lukeweston/SSRPGenericTelemetryModule/FGPMMOPA6x.png

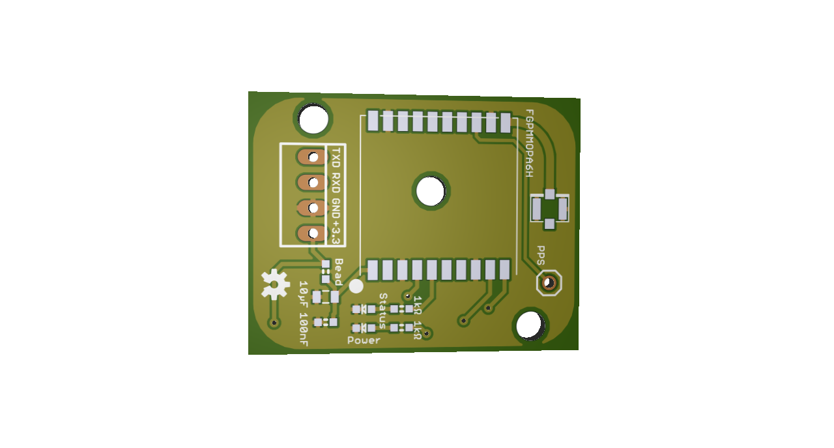
FGPMMOPA6x.png
