lukeweston/SSRPGenericTelemetryModule/HighRangeAccelerometer.png

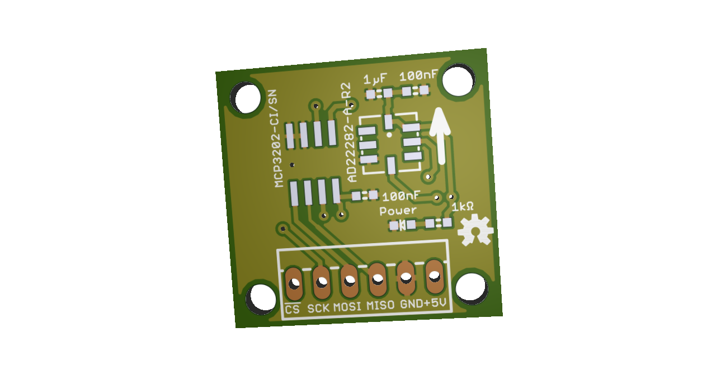
HighRangeAccelerometer.png
