lukeweston/SSRPGenericTelemetryModule/OEMV1_GPS_Interface.png

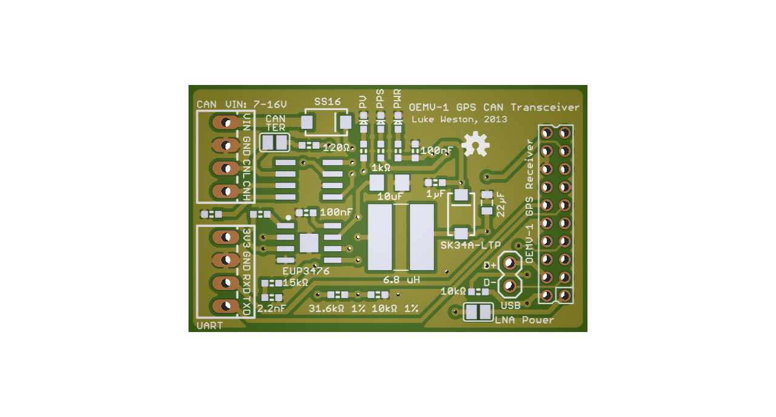
OEMV1_GPS_Interface.png
