lukeweston/SSRPGenericTelemetryModule/Venus638FLPX-L.png

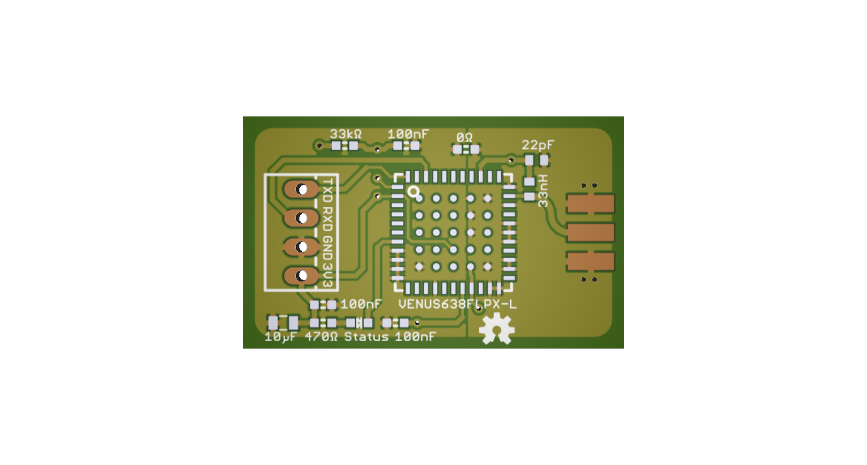
Venus638FLPX-L.png
