lukeweston/SSRPGenericTelemetryModule/FGPMMOPA6x-schematic.pdf

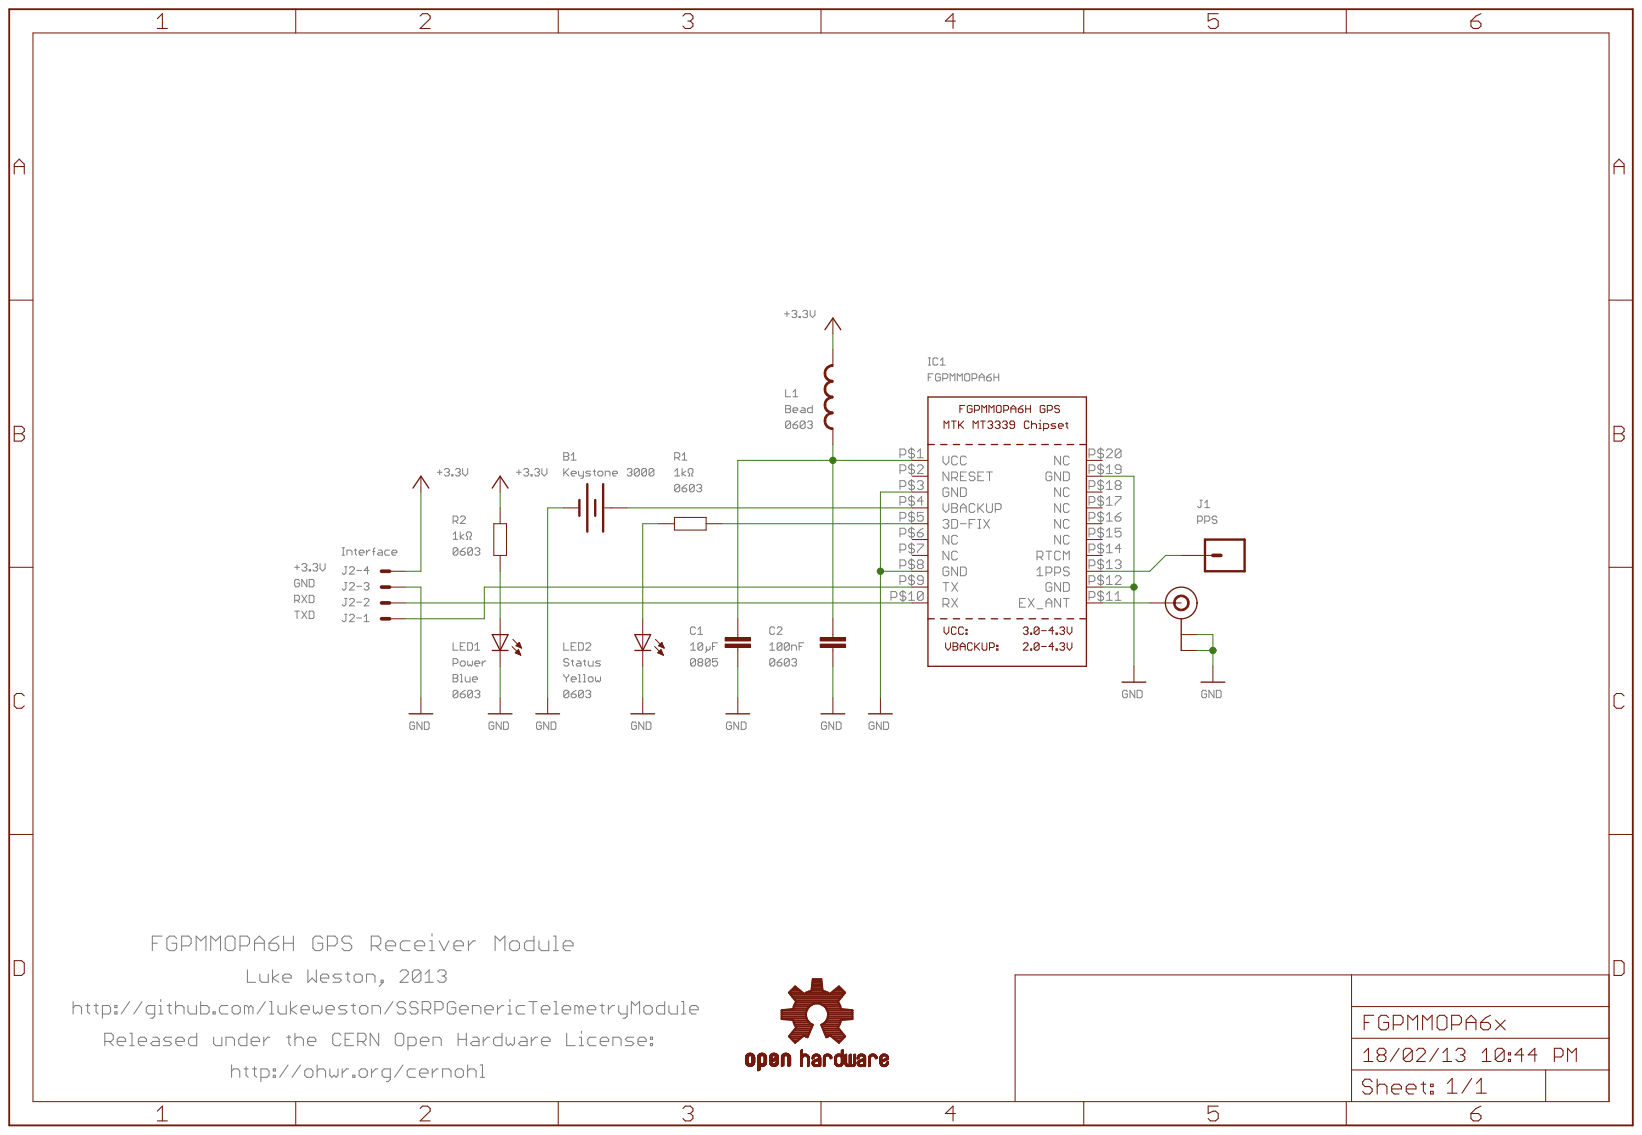
[picture p5: page 1]
