lukeweston/SSRPGenericTelemetryModule/Venus638FLPX-L-schematic.pdf

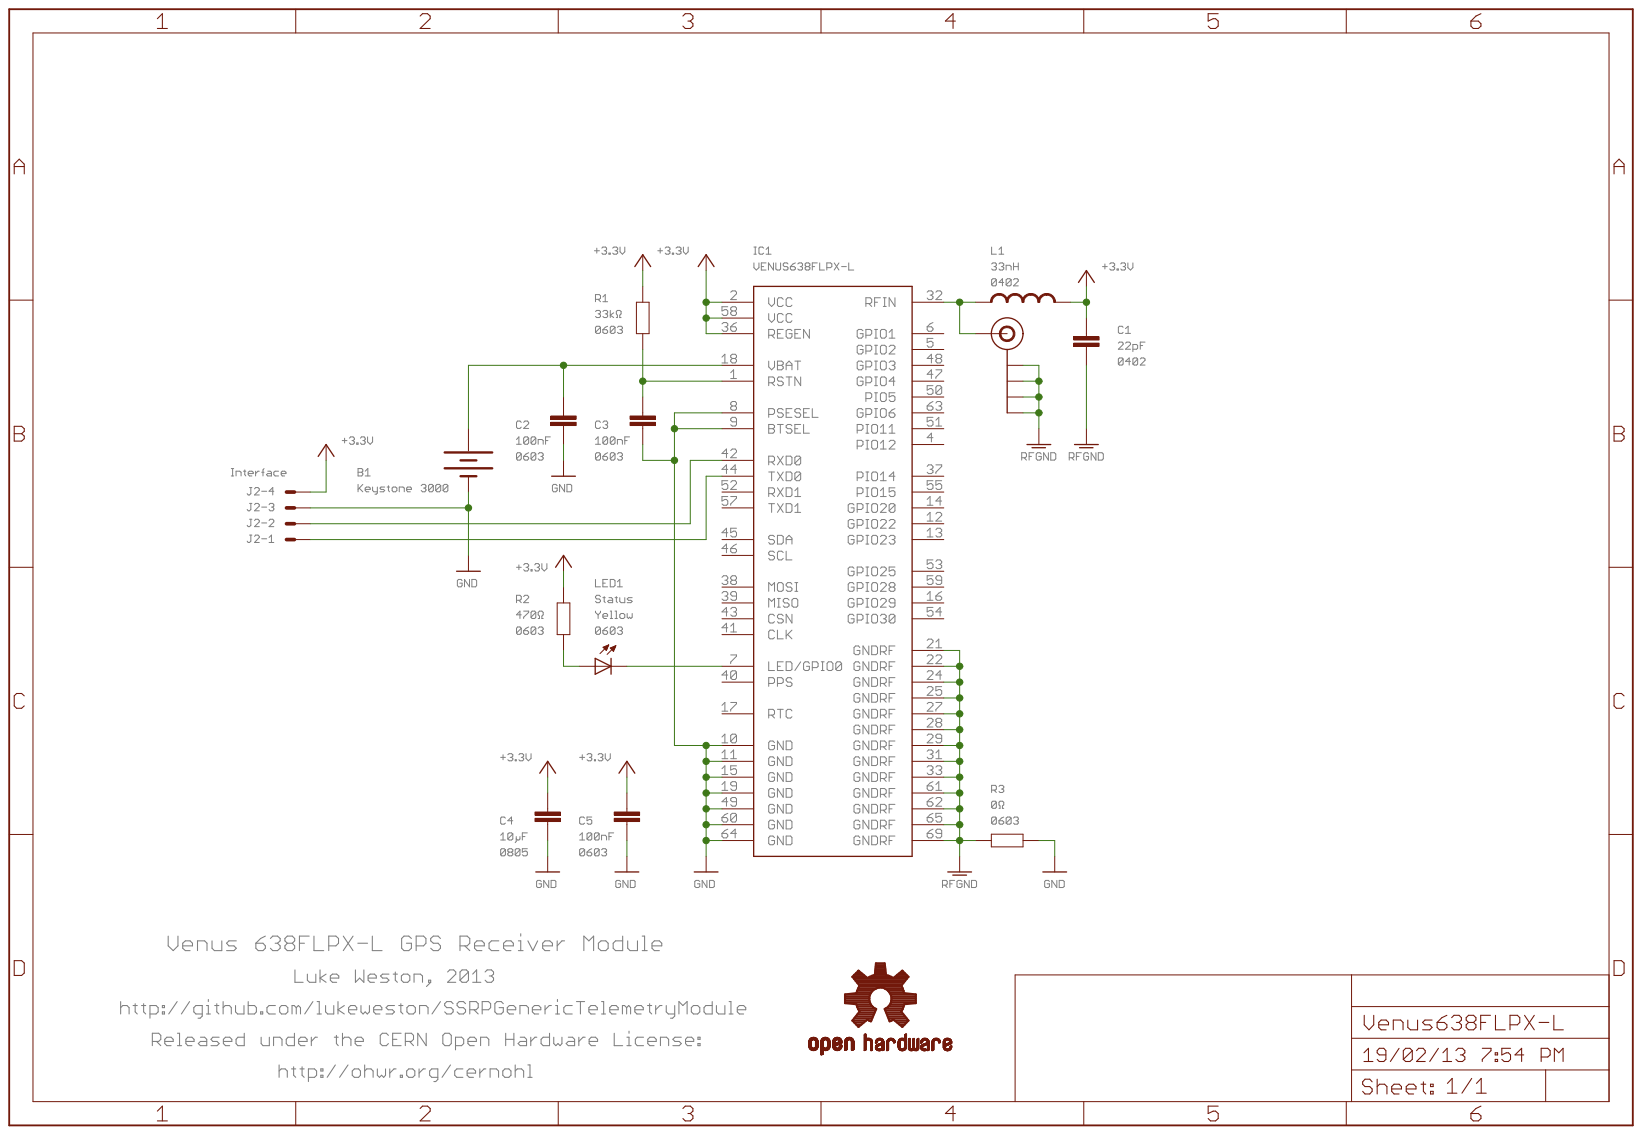
[picture p6: page 1]
