lukeweston/SSRPGenericTelemetryModule/OEMV1_GPS_Interface-schematic.pdf

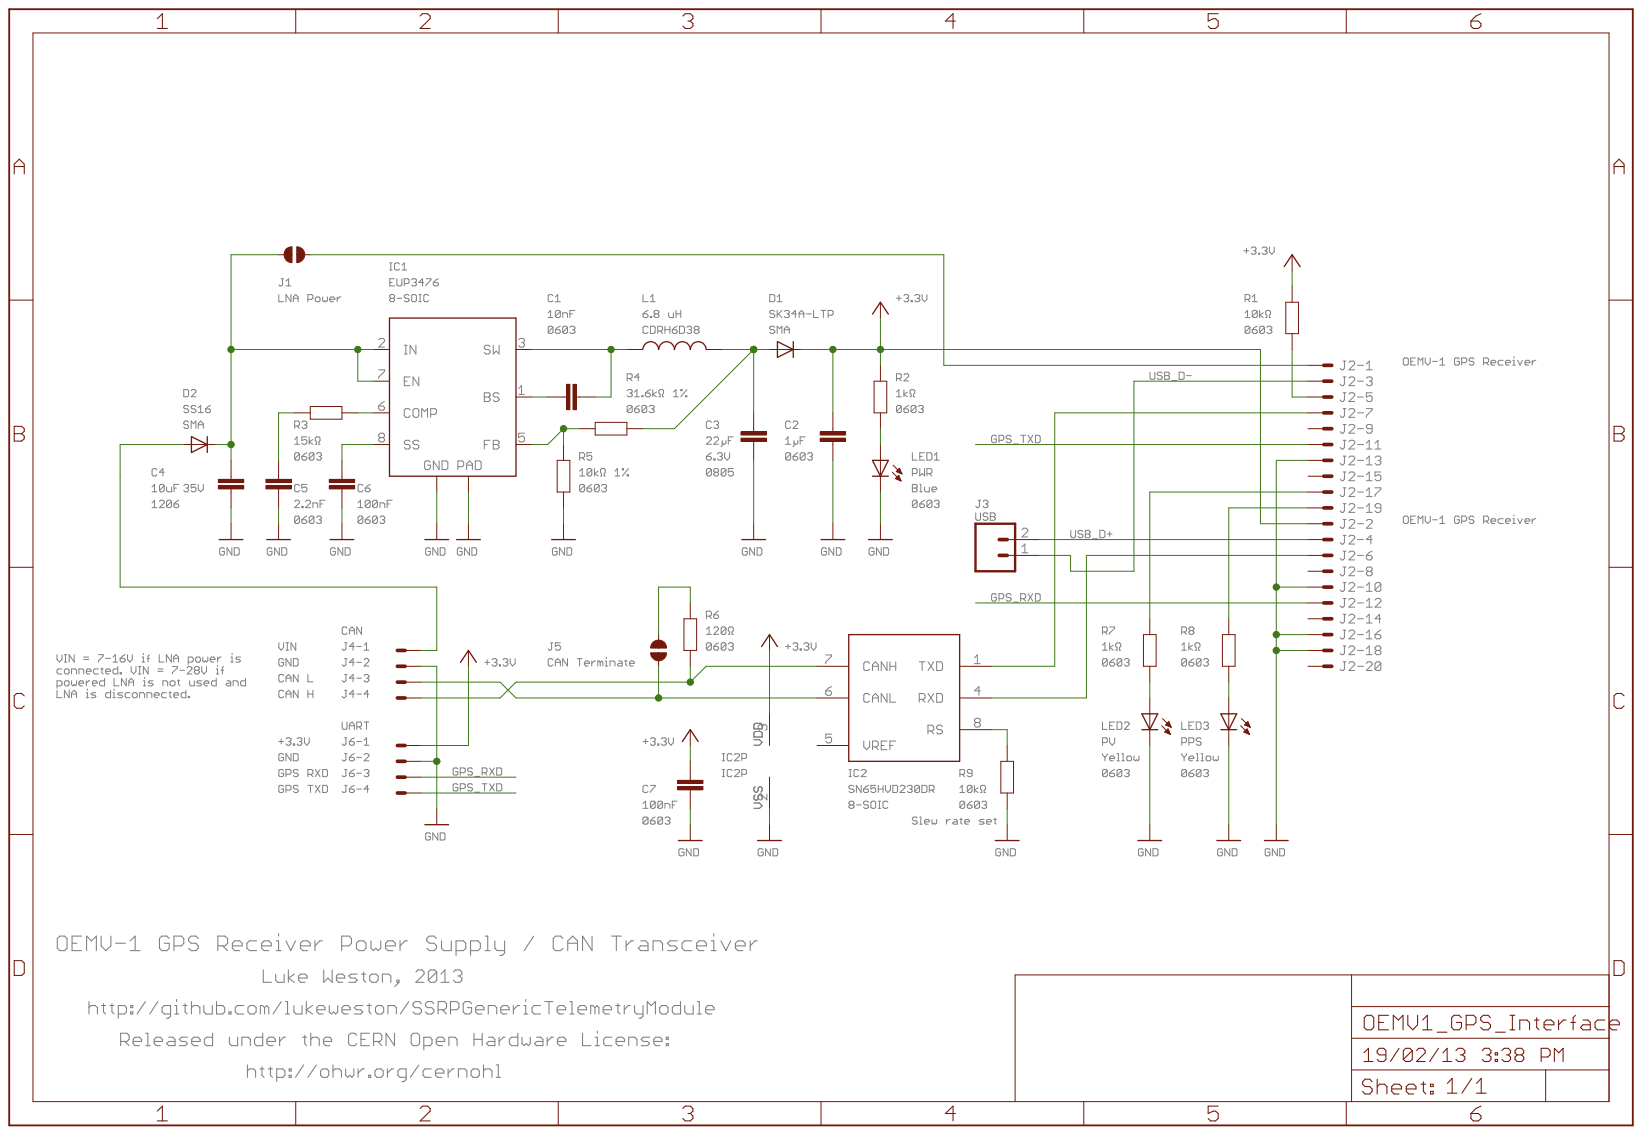
[picture p7: page 1]
