lukeweston/SSRPGenericTelemetryModule/HighRangeAccelerometer-schematic.pdf

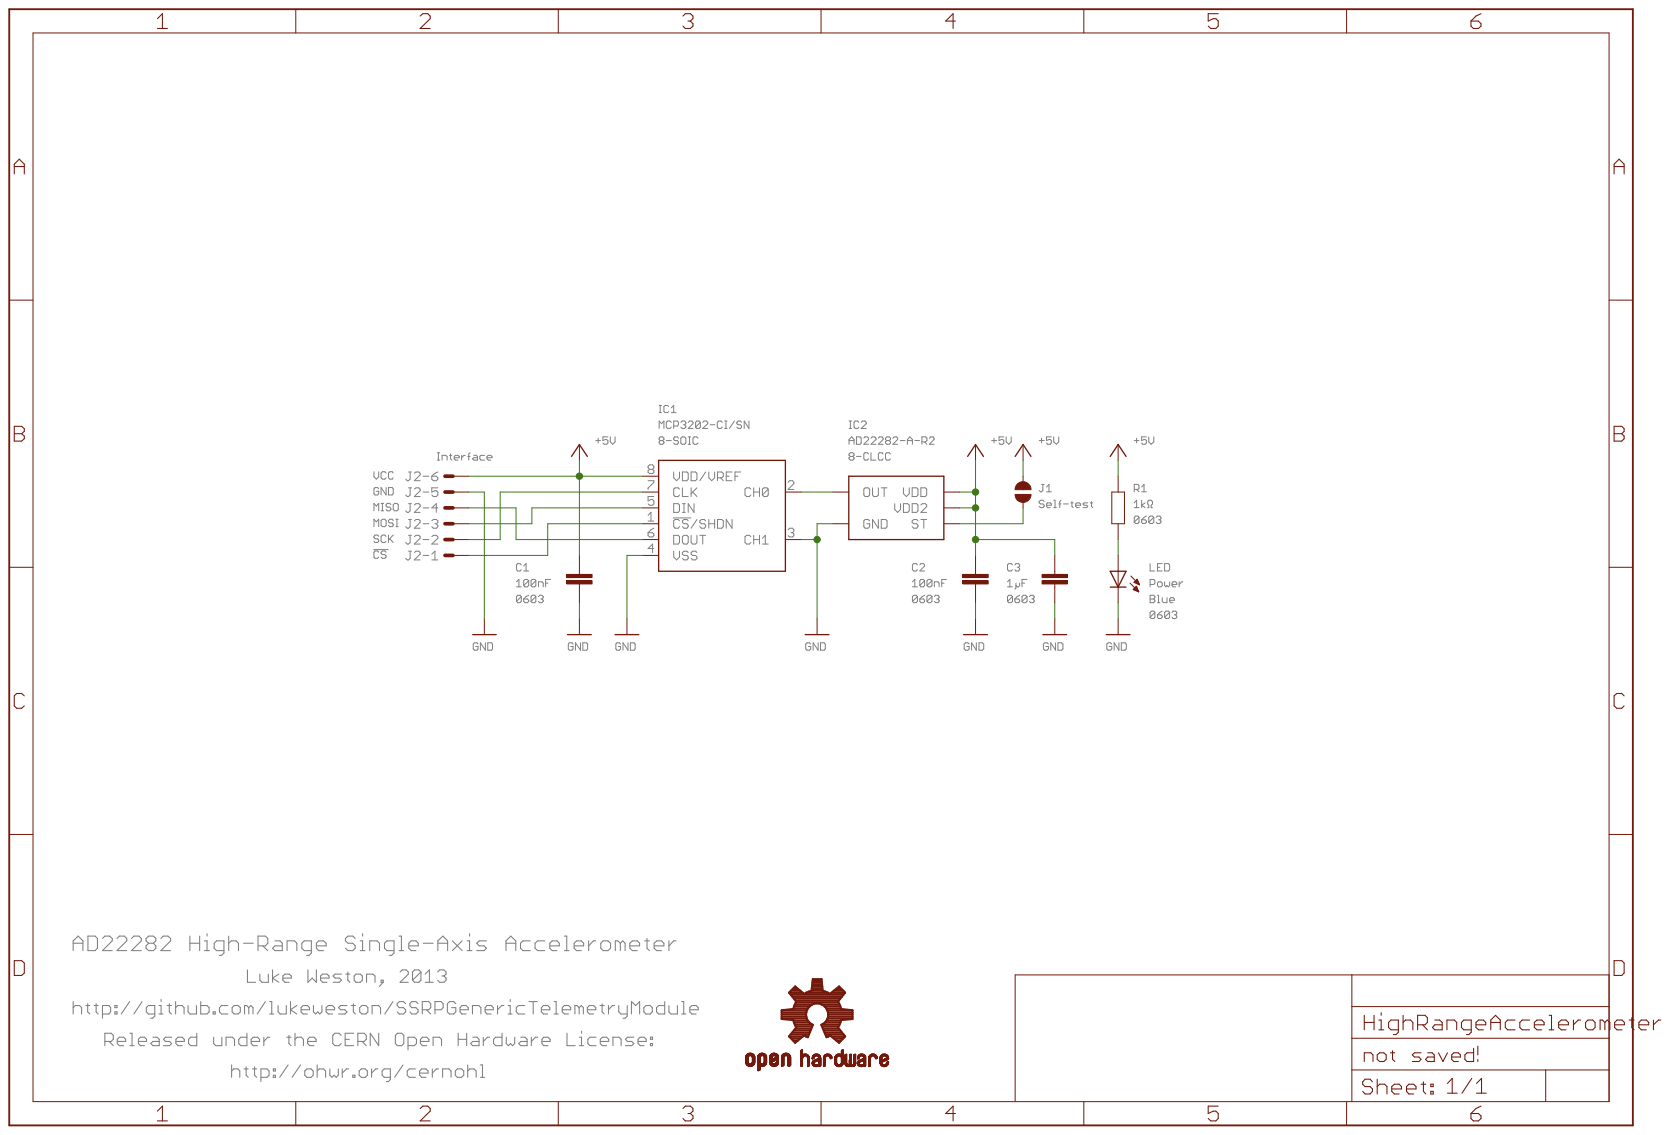
[picture p8: page 1]
