lukeweston/SSRPGenericTelemetryModule/HMTRPBreakoutModule-schematic.pdf

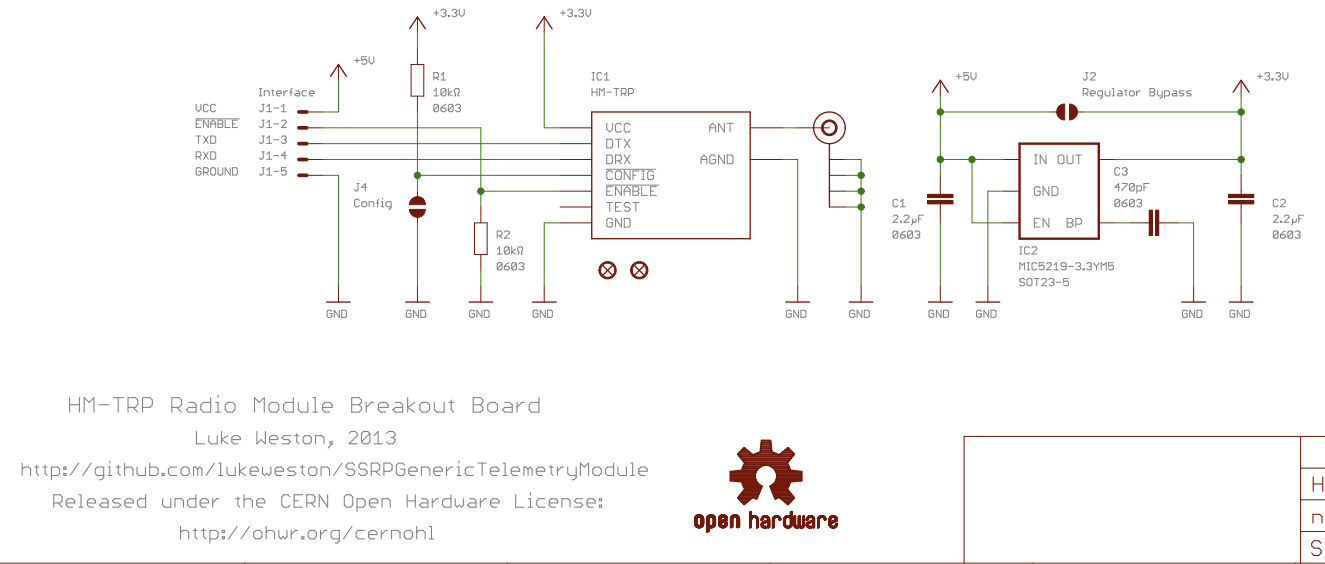
[picture p9: page 1]
