lukeweston/SSRPGenericTelemetryModule/RFD900module-schematic.pdf

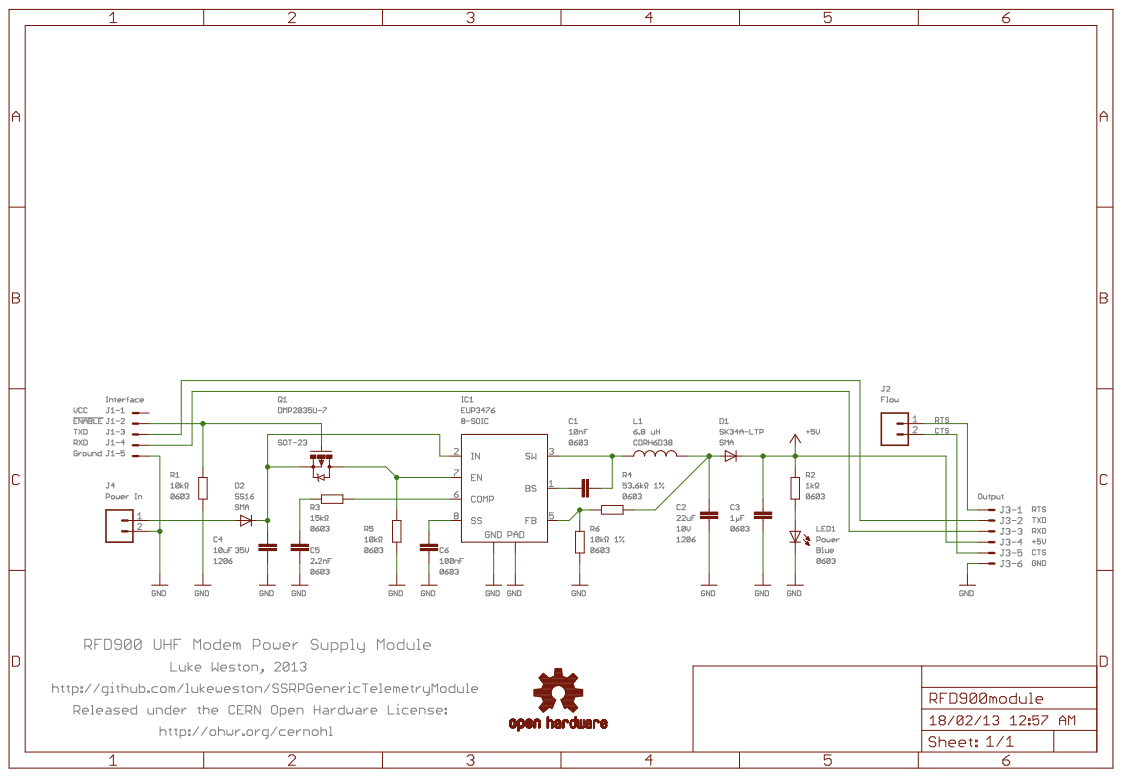
[picture p10: page 1]
