lukeweston/SSRPGenericTelemetryModule/OEMV1_GPS_Interface.brd

## EAGLE design OEMV1_GPS_Interface.brd (2013-02-19)

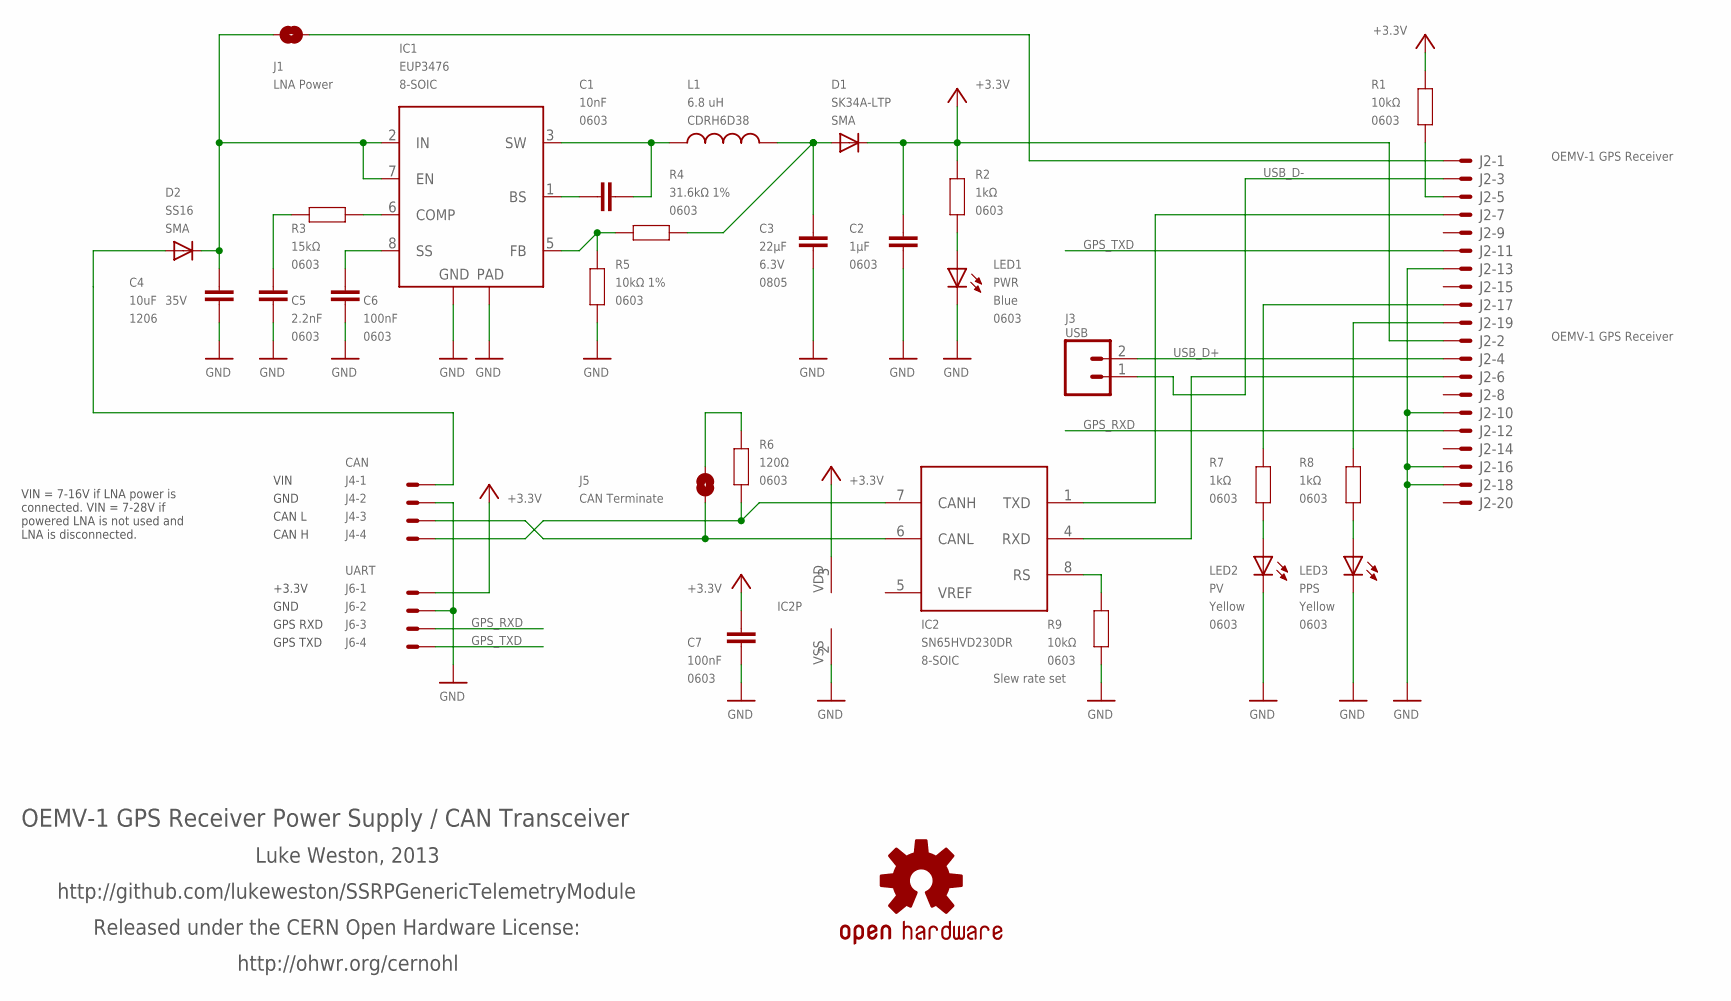
[picture p14: schematic OEMV1_GPS_Interface.sch]

Parts:
C1: 10nF; 0603
C2: 1µF; 0603
C3: 22µF; 0805; VOLTAGE 6.3V
C4: 10uF; C1206; VOLTAGE 35V
C5: 2.2nF; 0603
C6, C7: 100nF; 0603
D1: SK34A-LTP; SMA-DIODE
D2: SS16; SMA-DIODE
IC1: EUP3476; SO08T
IC2: SN65HVD230DR; SO-08
J1: LNA Power; SJ
J2: OEMV-1 GPS Receiver; 87758-2016
J3: USB; 1X02
J4: CAN; 22-23-2041
J5: CAN Terminate; SJ
J6: UART; 22-23-2041
L1: 6.8 uH; CDRH
LED1: PWR; LED-0603
LED2: PV; LED-0603
LED3: PPS; LED-0603
R1, R9: 10kΩ; 0603
R2, R7, R8: 1kΩ; 0603
R3: 15kΩ; 0603
R4: 31.6kΩ 1%; 0603
R5: 10kΩ 1%; 0603
R6: 120Ω; 0603
SY: OSHW-LOGOS; OSHW-LOGO-S

Connections:
!RESET: J2.5, R1.2
+3.3V: C2.2, C7.2, D1.C, IC2.3 (VDD), J2.2, J6.1, R1.1, R2.1
CANH: IC2.7 (CANH), J4.4, R6.1
CANL: IC2.6 (CANL), J4.3, J5.2
GND: C2.1, C3.2, C4.2, C5.1, C6.1, C7.1, IC1.4 (GND), IC1.9 (TGND), IC2.2 (VSS), J2.10, J2.13, J2.16, J2.18, J4.2, J6.2, LED1.C, LED2.C, LED3.C, R5.2, R9.2
GPS_CAN_RX: IC2.4 (RXD), J2.6
GPS_CAN_TX: IC2.1 (TXD), J2.7
GPS_RXD: J2.12, J6.3
GPS_TXD: J2.11, J6.4
unnamed: LED2.A, R7.1
unnamed: LED3.A, R8.1
unnamed: C1.2, IC1.1 (BS)
unnamed: D2.A, J4.1
unnamed: J5.1, R6.2
unnamed: C5.2, R3.2
unnamed: C3.1, D1.A, L1.2, R4.2
unnamed: LED1.A, R2.2
unnamed: C4.1, D2.C, IC1.2 (IN), IC1.7 (EN), J1.1
unnamed: C1.1, IC1.3 (SW), L1.1
unnamed: IC1.6 (COMP), R3.1
unnamed: C6.2, IC1.8 (SS)
unnamed: IC1.5 (FB), R4.1, R5.1
unnamed: IC2.8 (RS), R9.1
PPS_OUT: J2.19, R8.2
PV_OUT: J2.17, R7.2
USB_D+: J2.4, J3.2
USB_D-: J2.3, J3.1
VIN: J1.2, J2.1
VREF: IC2.5 (VREF)

Notes on the sheet:
OEMV-1 GPS Receiver Power Supply / CAN Transceiver
Luke Weston, 2013
http://github.com/lukeweston/SSRPGenericTelemetryModule
Released under the CERN Open Hardware License:
http://ohwr.org/cernohl
VIN
GND
CAN L
CAN H
+3.3V
GPS RXD
GPS TXD
VIN = 7-16V if LNA power is connected. VIN = 7-28V if powered LNA is not used and LNA is disconnected.

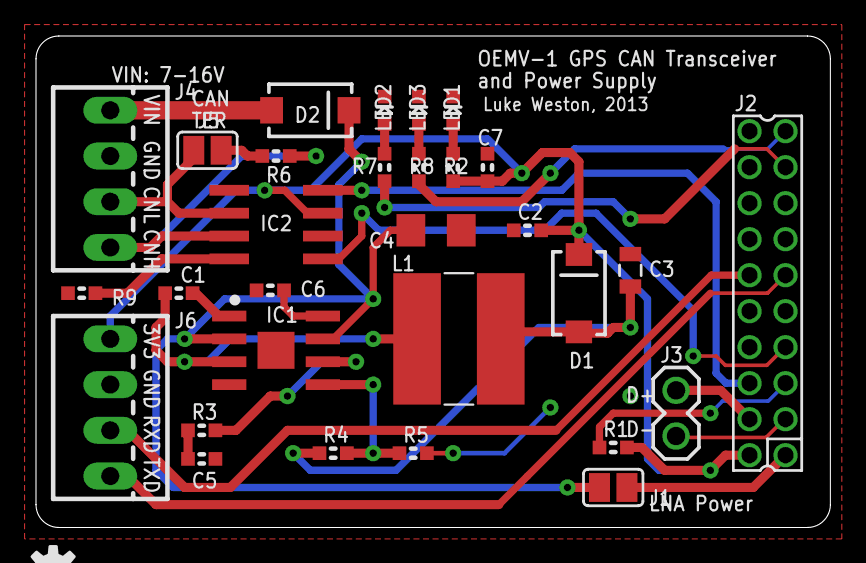
[picture p15: board OEMV1_GPS_Interface.brd from above]

Board: 2 copper layers, 44.1 x 27.3 mm, 31 parts (0 on the bottom side), 28 nets.
