lukeweston/SSRPGenericTelemetryModule/FGPMMOPA6x.brd

## EAGLE design FGPMMOPA6x.brd (2013-02-19)

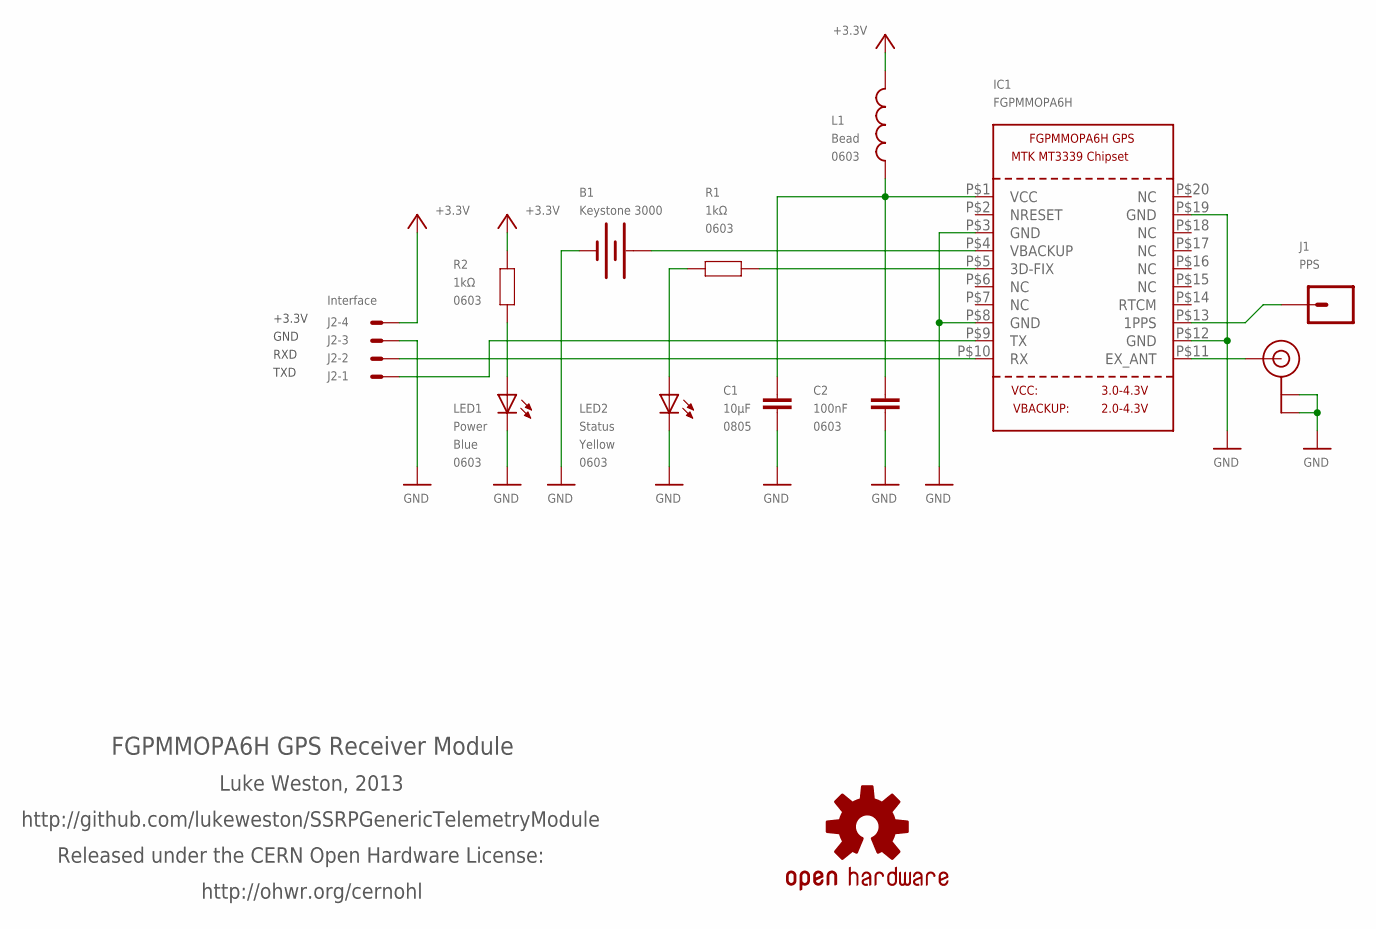
[picture p16: schematic FGPMMOPA6x.sch]

Parts:
B1: Keystone 3000; BATTCON_12MM
C1: 10µF; 0805
C2: 100nF; 0603
IC1: FGPMMOPA6H
J1: PPS; 1X01
J2: Interface; 22-23-2041
J3: U.FL
L1: Bead; 0603
LED1: Power; LED-0603
LED2: Status; LED-0603
R1, R2: 1kΩ; 0603
SY: OSHW-LOGOS; OSHW-LOGO-S

Connections:
+3V3: J2.4, L1.2, R2.2
GND: B1.GND (-), C1.1, C2.1, IC1.P$3 (GND), IC1.P$8 (GND), IC1.P$12 (GND), IC1.P$19 (GND), J2.3, J3.P$1 (GND), J3.P$2 (GND), LED1.C, LED2.C
unnamed: C1.2, C2.2, IC1.P$1 (VCC), L1.1
unnamed: B1.PWR@1 (+), IC1.P$4 (VBACKUP)
unnamed: IC1.P$5 (3D-FIX), R1.2
unnamed: IC1.P$9 (TX), J2.1
unnamed: IC1.P$10 (RX), J2.2
unnamed: IC1.P$13 (1PPS), J1.1
unnamed: IC1.P$11 (EX_ANT), J3.P$3 (SIGNAL)
unnamed: LED2.A, R1.1
unnamed: LED1.A, R2.1

Notes on the sheet:
FGPMMOPA6H GPS Receiver Module
Luke Weston, 2013
http://github.com/lukeweston/SSRPGenericTelemetryModule
Released under the CERN Open Hardware License:
http://ohwr.org/cernohl
+3.3V
GND
RXD
TXD

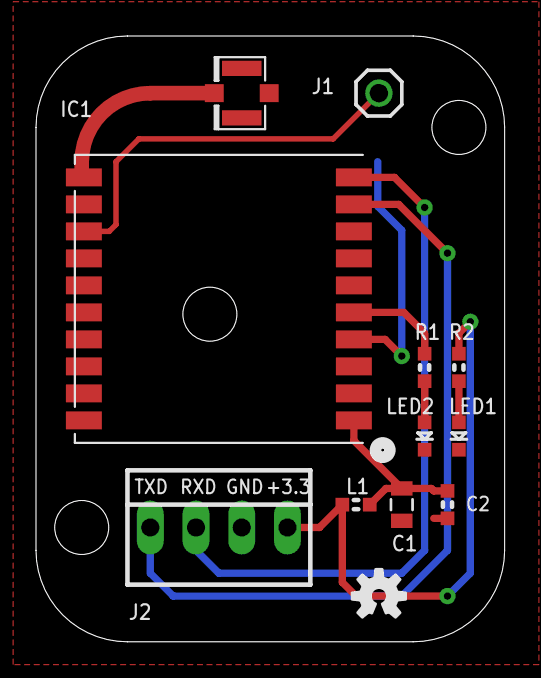
[picture p17: board FGPMMOPA6x.brd from above]

Board: 2 copper layers, 26.0 x 33.7 mm, 13 parts (1 on the bottom side), 11 nets.
