lukeweston/SSRPGenericTelemetryModule/Venus638FLPX-L.brd

## EAGLE design Venus638FLPX-L.brd (2013-02-19)

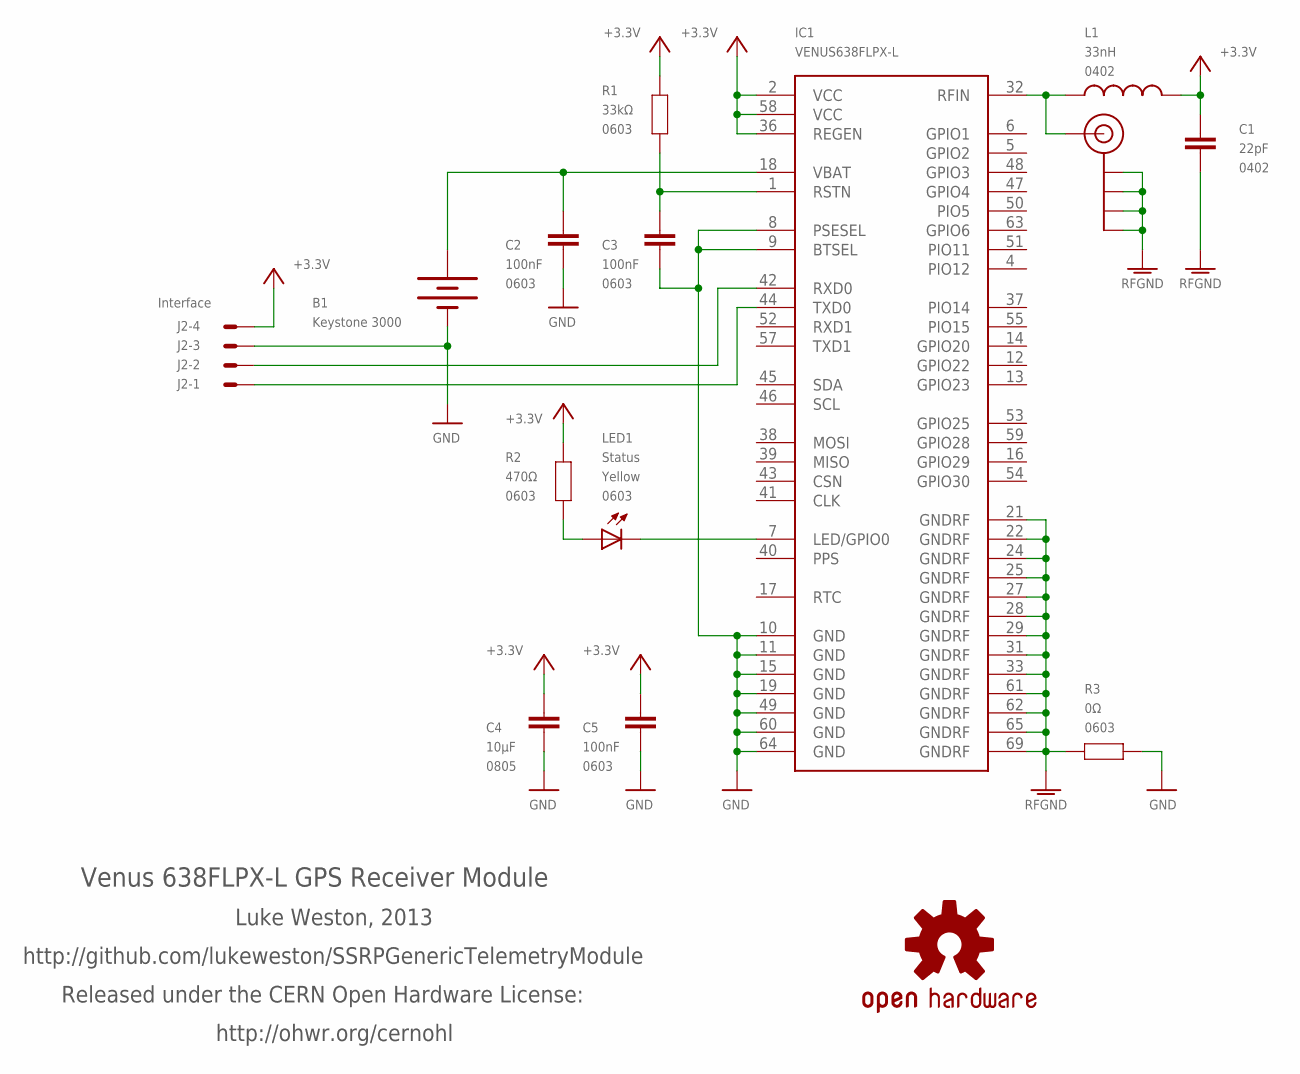
[picture p18: schematic Venus638FLPX-L.sch]

Parts:
B1: Keystone 3000; BATTCON_12MM
C1: 22pF; C0402
C2, C3, C5: 100nF; 0603
C4: 10µF; 0805
IC1: VENUS638FLPX-L; VENUS638FLPX
J1: Antenna; SMA-EDGE
J2: Interface; 22-23-2041
L1: 33nH; C0402
LED1: Status; LED-0603
R1: 33kΩ; 0603
R2: 470Ω; 0603
R3: 0Ω; 0603
SY: OSHW-LOGOS; OSHW-LOGO-S

Connections:
+3.3V: C1.2, C4.2, C5.2, IC1.2 (VCC), IC1.36 (REGEN), IC1.58 (VCC), J2.4, L1.1, R1.1, R2.1
ANT2: IC1.32 (RFIN), J1.SIG (SIGNAL), L1.2
GND: B1.GND (-), C2.1, C3.1, C4.1, C5.1, IC1.8 (PSESEL), IC1.9 (BTSEL), IC1.10 (GND), IC1.11 (GND), IC1.15 (GND), IC1.19 (GND), IC1.49 (GND), IC1.60 (GND), IC1.64 (GND), J2.3, R3.1
unnamed: C3.2, IC1.1 (RSTN), R1.2
unnamed: B1.PWR@1 (+), C2.2, IC1.18 (VBAT)
unnamed: IC1.7 (LED/GPIO0), LED1.C
unnamed: LED1.A, R2.2
RFGND: C1.1, IC1.21 (GNDRF), IC1.22 (GNDRF), IC1.24 (GNDRF), IC1.25 (GNDRF), IC1.27 (GNDRF), IC1.28 (GNDRF), IC1.29 (GNDRF), IC1.31 (GNDRF), IC1.33 (GNDRF), IC1.61 (GNDRF), IC1.62 (GNDRF), IC1.65 (GNDRF), IC1.69 (GNDRF), J1.GND@0 (GND), J1.GND@1 (GND), J1.GND@2 (GND), J1.GND@3 (GND), R3.2
RXD: IC1.42 (RXD0), J2.2
TXD: IC1.44 (TXD0), J2.1

Notes on the sheet:
Venus 638FLPX-L GPS Receiver Module
Luke Weston, 2013
http://github.com/lukeweston/SSRPGenericTelemetryModule
Released under the CERN Open Hardware License:
http://ohwr.org/cernohl

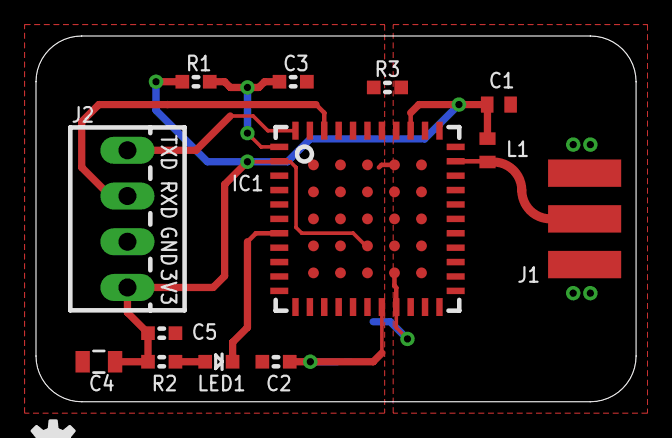
[picture p19: board Venus638FLPX-L.brd from above]

Board: 2 copper layers, 33.3 x 20.3 mm, 15 parts (1 on the bottom side), 10 nets.
