lukeweston/SSRPGenericTelemetryModule/SSRPGenericTelemetryModule.brd

## EAGLE design SSRPGenericTelemetryModule.brd (2013-02-17)

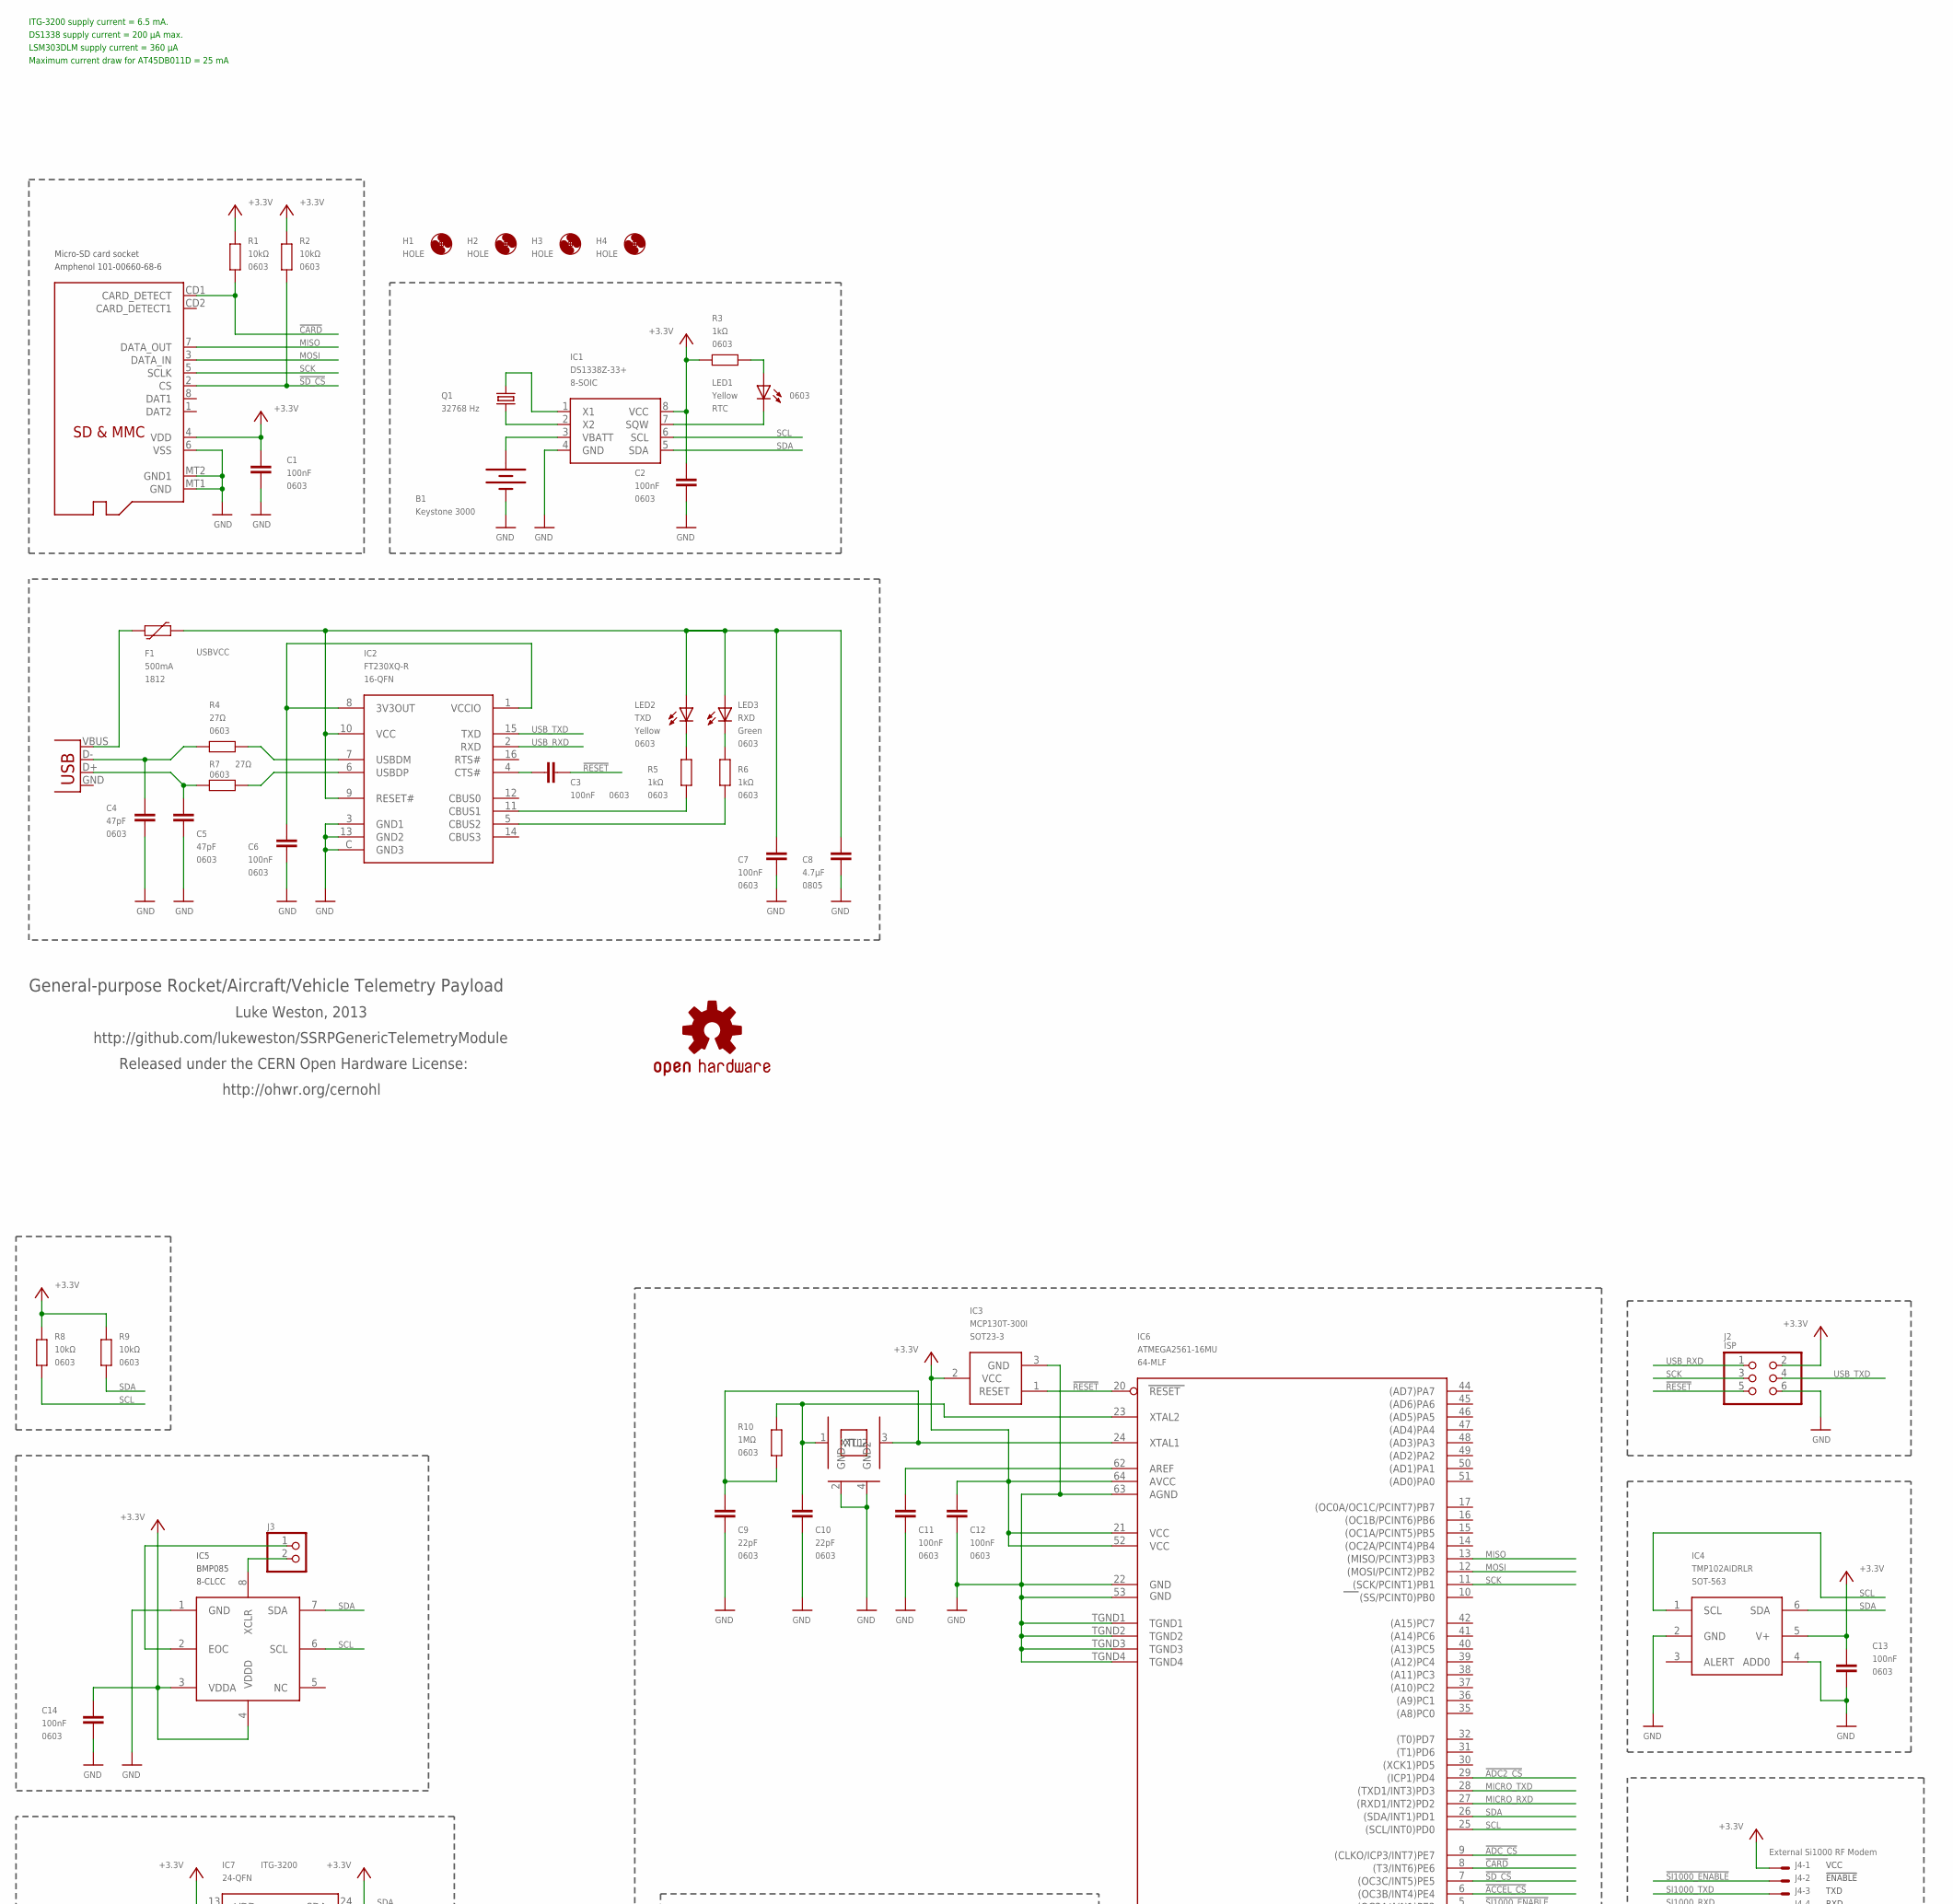
[picture p20: schematic SSRPGenericTelemetryModule.sch, part in row 1, column 1]

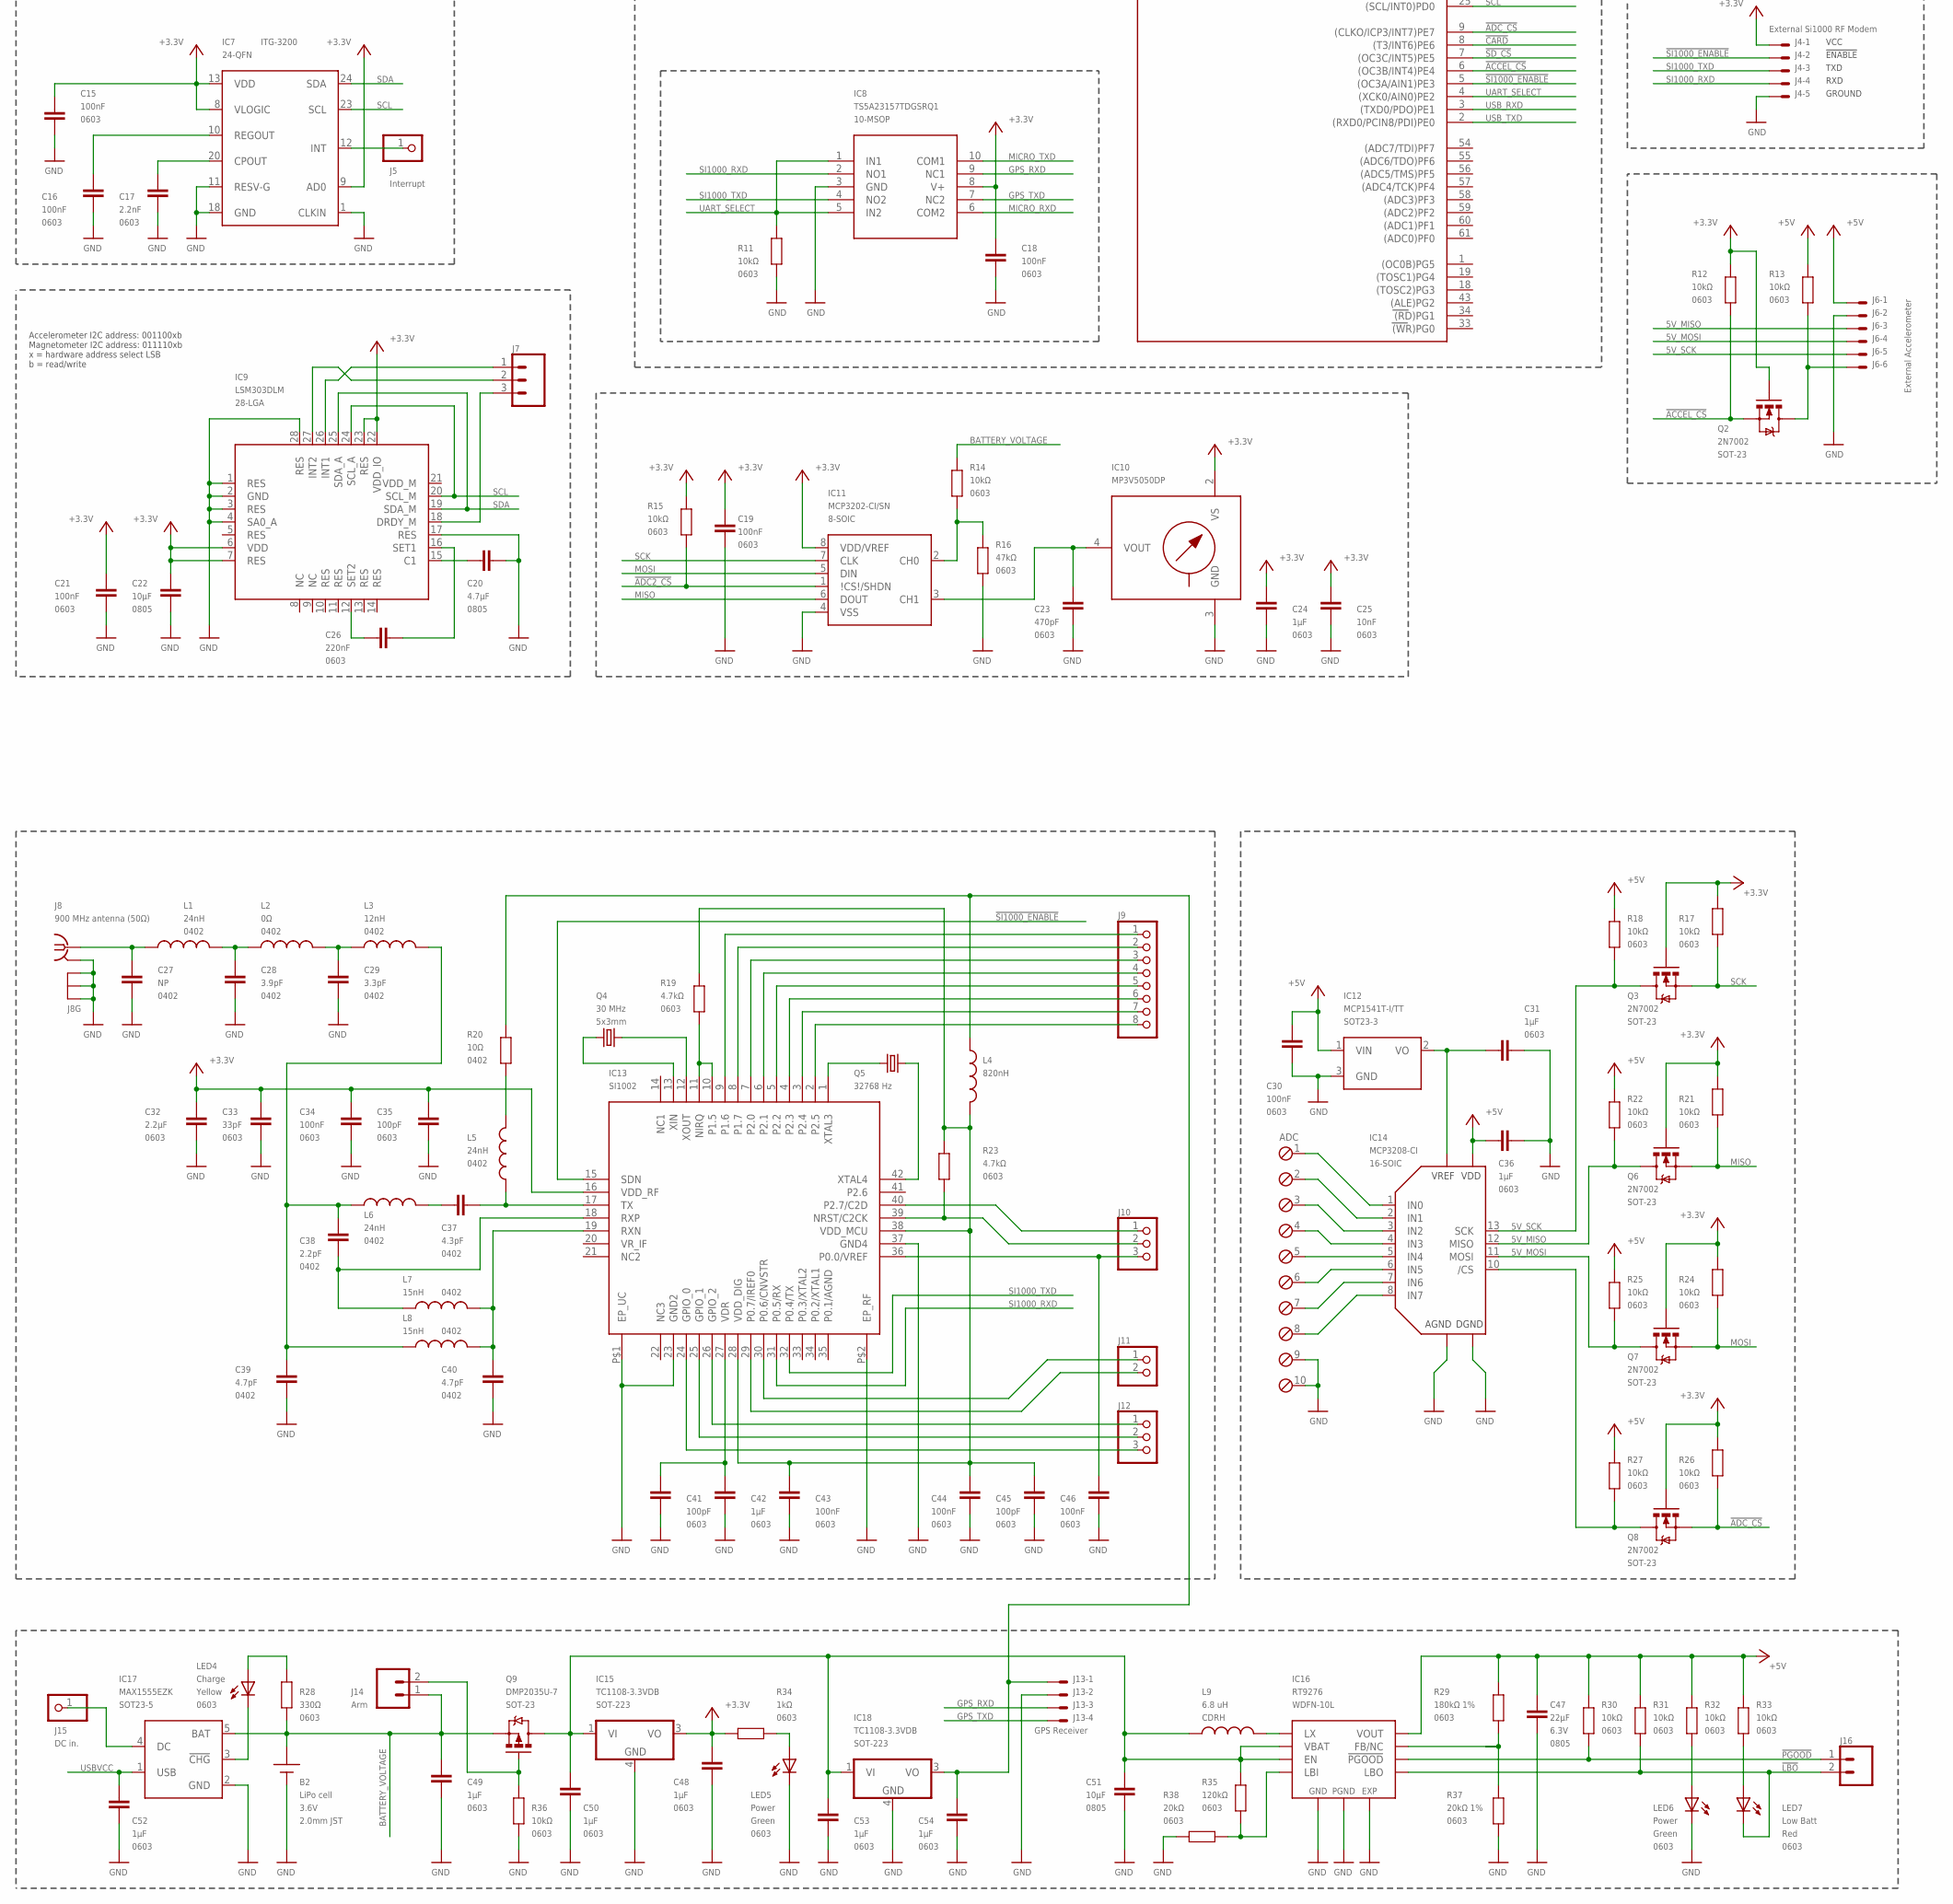
[picture p21: schematic SSRPGenericTelemetryModule.sch, part in row 2, column 1]

Parts:
B1: Keystone 3000; BATTCON_12MM
B2: LiPo cell; JST-2MM-TH-RA; VOLTAGE 3.6V
C1, C2, C3, C6, C7, C11, C12, C13, C14, C15, C16, C18, C19, C21, C30, C34, C43, C44, C46: 100nF; 0603
C4, C5: 47pF; 0603
C8, C20: 4.7µF; 0805
C9, C10: 22pF; 0603
C17: 2.2nF; 0603
C22, C51: 10µF; 0805
C23: 470pF; 0603
C24, C31, C36, C42, C48, C49, C50, C52, C53, C54: 1µF; 0603
C25: 10nF; 0603
C26: 220nF; 0603
C27: NP; C0402
C28: 3.9pF; C0402
C29: 3.3pF; C0402
C32: 2.2µF; 0603
C33: 33pF; 0603
C35, C41, C45: 100pF; 0603
C37: 4.3pF; C0402
C38: 2.2pF; C0402
C39, C40: 4.7pF; C0402
C47: 22µF; 0805; VOLTAGE 6.3V
F1: 500mA; 1812
H1, H2, H3, H4: HOLE; 3,2
IC1: DS1338Z-33+; SO08@1
IC2: FT230XQ-R; QFN4X4-16
IC3: MCP130T-300I; SOT23-3
IC4: TMP102AIDRLR; SOT563
IC5: BMP085
IC6: ATMEGA2561-16MU; MLF64
IC7: ITG-3200; QFN-24
IC8: TS5A23157TDGSRQ1; MSOP10
IC9: LSM303DLM; LGA28-5X5
IC10: MP3V5050DP; 1351
IC11: MCP3202-CI/SN; SO-08
IC12: MCP1541T-I/TT; SOT23
IC13: SI1002; QFN42_MCM
IC14: MCP3208-CI; SOIC16
IC15, IC18: TC1108-3.3VDB; SOT223
IC16: RT9276; WDFN-10L-3X3
IC17: MAX1555EZK; SOT23-5L
J1: MicroSD Card; ADAFRUIT_MICROSD
J2: ISP; 2X03PTH
J3, J11: PINHD-1X2; 1X02
J4: External Si1000 RF Modem; 22-23-2051
J5: Interrupt; 1X01
J6: External Accelerometer; 7395-06
J7: M03PTH; 1X03
J8: 900 MHz antenna (50Ω); J502-ND-142-0701-801/806
J9: PINHD-1X8; 1X08
J10, J12: PINHD-1X3; 1X03
J13: GPS Receiver; 7395-04
J14: Arm; 1X02
J15: DC in.; 1X01
J16: Status; 1X02
L1, L5, L6: 24nH; C0402
L2: 0Ω; C0402
L3: 12nH; C0402
L4: 820nH; C0402
L7, L8: 15nH; C0402
L9: 6.8 uH; CDRH
LED1: RTC; LED-0603
LED2: TXD; LED-0603
LED3: RXD; LED-0603
LED4: Charge; LED-0603
LED5, LED6: Power; LED-0603
LED7: Low Batt; LED-0603
Q1, Q5: 32768 Hz; SMD3215_XTAL
Q2, Q3, Q6, Q7, Q8: 2N7002; SOT23-3
Q4: 30 MHz; CRYSTAL-SMD-5X3
Q9: DMP2035U-7; SOT23-3
R1, R2, R8, R9, R11, R12, R13, R14, R15, R17, R18, R21, R22, R24, R25, R26, R27, R30, R31, R32, R33, R36: 10kΩ; 0603
R3, R5, R6, R34: 1kΩ; 0603
R4, R7: 27Ω; 0603
R10: 1MΩ; 0603
R16: 47kΩ; 0603
R19, R23: 4.7kΩ; 0603
R20: 10Ω; C0402
R28: 330Ω; 0603
R29: 180kΩ 1%; 0603
R35: 120kΩ; 0603
R37: 20kΩ 1%; 0603
R38: 20kΩ; 0603
SY: OSHW-LOGOS; OSHW-LOGO-S
X1: USB-MICROB
X2: ADC; 10POL254
XTL1: SMD3225-16MHZ 3.2 x 2.5mm crystal; CRYSTAL-SMD-3X2

Connections:
5V_MISO: IC14.12 (MISO), J6.3, Q6.3 (D), R22.1
5V_MOSI: IC14.11 (MOSI), J6.4, Q7.3 (D), R25.1
5V_SCK: IC14.13 (SCK), J6.5, Q3.3 (D), R18.1
!ACCEL_CS: IC6.6 ((OC3B/INT4)PE4), Q2.2 (S), R12.1
!ADC2_CS: IC6.29 ((ICP1)PD4), IC11.1 (\!CS\!/SHDN), R15.1
!ADC_CS: IC6.9 ((CLKO/ICP3/INT7)PE7), Q8.2 (S), R26.1
!ADC_CS_5V: IC14.10 (/CS), Q8.3 (D), R27.1
!CARD: IC6.8 ((T3/INT6)PE6), J1.CD1 (CARD_DETECT), R1.2
!LBO: IC16.4 (LBO), J16.2, LED7.C, R31.1
!PGOOD: IC16.8 (!PGOOD), J16.1, R30.1
!RESET: C3.2, IC3.1 (RESET), IC6.20 (RESET), J2.5
!SD_CS: IC6.7 ((OC3C/INT5)PE5), J1.2 (CS), R2.2
!SI1000_ENABLE: IC6.5 ((OC3A/AIN1)PE3), IC13.15 (SDN), J4.2
+3V3: C1.1, C2.1, C12.1, C13.1, C14.1, C15.1, C18.2, C19.1, C21.2, C22.2, C24.1, C25.1, C32.2, C33.2, C34.2, C35.2, C48.1, IC1.8 (VCC), IC3.2 (VCC), IC4.5 (V+), IC5.3 (VDDA), IC5.4 (VDDD), IC6.21 (VCC), IC6.52 (VCC1), IC6.64 (AVCC), IC7.8 (VLOGIC), IC7.9 (AD0), IC7.13 (VDD), IC8.8 (V+), IC9.6 (VDD), IC9.7 (RES), IC9.22 (VDD_IO), IC9.23 (RES), IC10.2 (VS), IC11.8 (VDD/VREF), IC13.16 (VDD_RF), IC15.3 (VO), J1.4 (VDD), J2.2, J4.1, Q2.1 (G), Q3.1 (G), Q6.1 (G), Q7.1 (G), Q8.1 (G), R1.1, R2.1, R3.2, R8.2, R9.2, R12.2, R15.2, R17.2, R21.2, R24.2, R26.2, R34.2
+5V: C30.2, C36.1, C47.1, IC12.1 (VIN), IC14.16 (VDD), IC16.2 (VOUT), J6.1, R13.2, R18.2, R22.2, R25.2, R27.2, R29.2, R30.2, R31.2, R32.2, R33.2
ANALOG_BAROMETER: C23.1, IC10.4 (VOUT), IC11.3 (CH1)
BATTERY_VOLTAGE: B2.+, C49.1, IC17.5 (BAT), J14.1, Q9.2 (S), R14.2, R28.1
FB1: IC16.3 (FB/NC), R29.1, R37.2
GND: B1.GND (-), B2.-, C1.2, C2.2, C4.2, C5.2, C6.2, C7.2, C8.2, C9.2, C10.2, C11.2, C12.2, C13.2, C14.2, C15.2, C16.2, C17.2, C18.1, C19.2, C20.2, C21.1, C22.1, C23.2, C24.2, C25.2, C27.2, C28.2, C29.2, C30.1, C31.2, C32.1, C33.1, C34.1, C35.1, C36.2, C39.2, C40.2, C41.1, C42.1, C43.1, C44.1, C45.1, C46.1, C47.2, C48.2, C49.2, C50.2, C51.2, C52.2, C53.2, C54.2, IC1.4 (GND), IC2.3 (GND1), IC2.13 (GND2), IC2.C (GND3), IC3.3 (GND), IC4.2 (GND), IC4.4 (ADD0), IC5.1 (GND), IC6.22 (GND), IC6.53 (GND1), IC6.63 (AGND), IC6.TGND1, IC6.TGND2, IC6.TGND3, IC6.TGND4, IC7.1 (CLKIN), IC7.11 (RESV-G), IC7.18 (GND), IC8.3 (GND), IC9.1 (RES), IC9.2 (GND), IC9.3 (RES), IC9.4 (SA0_A), IC9.17 (RES), IC9.28 (RES), IC10.3 (GND), IC11.4 (VSS), IC12.3 (GND), IC13.23 (GND2), IC13.37 (GND4), IC13.EP1 (GND5), IC13.EP2 (GND6), IC13.EP3 (GND7), IC13.EP4 (GND8), IC13.EP5 (GND9), IC13.EP6 (GND10), IC13.EP7 (GND11), IC13.EP8 (GND12), IC13.P$1 (EP_UC), IC13.P$2 (EP_RF), IC14.9 (DGND), IC14.14 (AGND), IC15.4 (GND), IC16.5 (GND), IC16.10 (PGND), IC16.EXP, IC17.2 (GND), IC18.4 (GND), J1.6 (VSS), J1.MT1 (GND), J1.MT2 (GND1), J2.6, J4.5, J6.2, J8.G@1 (GND), J8.G@2 (GND), J8.G@3 (GND), J8.G@4 (GND), J13.2, LED5.C, LED6.C, R11.1, R16.1, R36.1, R37.1, R38.1, X2.9, X2.10, XTL1.2 (GND), XTL1.4 (GND2)
GPS_RXD: IC8.9 (NC1), J13.3
GPS_TXD: IC8.7 (NC2), J13.4
LBI1: IC16.7 (LBI), R35.1, R38.2
LX1: IC16.9 (LX), L9.2
MICRO_RXD: IC6.27 ((RXD1/INT2)PD2), IC8.6 (COM2)
MICRO_TXD: IC6.28 ((TXD1/INT3)PD3), IC8.10 (COM1)
MISO: IC6.13 ((MISO/PCINT3)PB3), IC11.6 (DOUT), J1.7 (DATA_OUT), Q6.2 (S), R21.1
MOSI: IC6.12 ((MOSI/PCINT2)PB2), IC11.5 (DIN), J1.3 (DATA_IN), Q7.2 (S), R24.1
unnamed: J6.6, Q2.3 (D), R13.1
unnamed: C43.2, C44.2, C45.2, IC13.28 (VDD_DIG), IC13.38 (VDD_MCU), L4.1, R19.2, R23.2
unnamed: C38.2, IC13.18 (RXP), L7.2
unnamed: IC13.40 (P2.7/C2D), J10.1
unnamed: IC9.18 (DRDY_M), J7.3
unnamed: C27.1, J8.1, L1.1
unnamed: IC13.1 (XTAL3), Q5.X2 (2)
unnamed: IC13.42 (XTAL4), Q5.X1 (1)
unnamed: IC13.30 (P0.6/CNVSTR), J11.1
unnamed: IC9.27 (INT2), J7.2
unnamed: C11.1, IC6.62 (AREF)
unnamed: IC1.2 (X2), Q1.X2 (2)
unnamed: B1.PWR@1 (+), IC1.3 (VBATT)
unnamed: IC1.1 (X1), Q1.X1 (1)
unnamed: IC1.7 (SQW), LED1.C
unnamed: IC9.26 (INT1), J7.1
unnamed: C26.1, IC9.12 (SET2)
unnamed: C26.2, IC9.16 (SET1)
unnamed: C10.1, IC6.23 (XTAL2), R10.1, XTL1.1 (XTL1)
unnamed: C20.1, IC9.15 (C1)
unnamed: IC13.29 (P0.7/IREF0), J11.2
unnamed: IC7.12 (INT), J5.1
unnamed: C9.1, IC6.24 (XTAL1), R10.2, XTL1.3 (XTL2)
unnamed: LED1.A, R3.1
unnamed: C16.1, IC7.10 (REGOUT)
unnamed: LED2.C, R5.2
unnamed: C17.1, IC7.20 (CPOUT)
unnamed: C54.1, IC18.3 (VO), J13.1, L4.2, R20.2
unnamed: IC14.8 (IN7), X2.8
unnamed: IC14.7 (IN6), X2.7
unnamed: LED3.C, R6.2
unnamed: C6.1, IC2.1 (VCCIO), IC2.8 (3V3OUT)
unnamed: IC5.8 (XCLR), J3.2
unnamed: IC5.2 (EOC), J3.1
unnamed: IC11.2 (CH0), R14.1, R16.2
unnamed: IC14.6 (IN5), X2.6
unnamed: IC14.5 (IN4), X2.5
unnamed: IC14.4 (IN3), X2.4
unnamed: IC14.3 (IN2), X2.3
unnamed: IC14.2 (IN1), X2.2
unnamed: IC14.1 (IN0), X2.1
unnamed: IC2.7 (USBDM), R4.2
unnamed: C31.1, IC12.2 (VO), IC14.15 (VREF)
unnamed: LED6.A, R32.1
unnamed: IC2.6 (USBDP), R7.2
unnamed: C5.1, R7.1, X1.D+
unnamed: C4.1, R4.1, X1.D-
unnamed: F1.1, X1.VBUS
unnamed: IC2.11 (CBUS1), R5.1
unnamed: IC2.5 (CBUS2), R6.1
unnamed: C3.1, IC2.4 (CTS#)
unnamed: LED7.A, R33.1
unnamed: IC13.24 (GPIO_0), J12.3
unnamed: IC13.25 (GPIO_1), J12.2
unnamed: IC13.26 (GPIO_2), J12.1
unnamed: C41.2, C42.2, IC13.27 (VDR)
unnamed: C46.2, IC13.36 (P0.0/VREF), J10.3
unnamed: J14.2, Q9.1 (G), R36.2
unnamed: IC17.3 (!CHG), LED4.C
unnamed: LED4.A, R28.2
unnamed: IC17.4 (DC), J15.1
unnamed: LED5.A, R34.1
unnamed: IC13.39 (NRST/C2CK), J10.2, R23.1
unnamed: IC13.2 (P2.5), J9.8
unnamed: IC13.3 (P2.4), J9.7
unnamed: IC13.4 (P2.3), J9.6
unnamed: IC13.5 (P2.2), J9.5
unnamed: IC13.6 (P2.1), J9.4
unnamed: IC13.7 (P2.0), J9.3
unnamed: IC13.8 (P1.7), J9.2
unnamed: IC13.9 (P1.6), J9.1
unnamed: IC13.10 (P1.5), IC13.11 (NIRQ), R19.1
unnamed: IC13.12 (XOUT), Q4.3 (2)
unnamed: IC13.13 (XIN), Q4.1
unnamed: C37.1, IC13.17 (TX), L5.1
unnamed: C37.2, L6.2
unnamed: C40.1, IC13.19 (RXN), L7.1, L8.1
unnamed: L5.2, R20.1
unnamed: C28.1, L1.2, L2.1
unnamed: C29.1, L2.2, L3.1
unnamed: C38.1, C39.1, L3.2, L6.1, L8.2
SCK: IC6.11 ((SCK/PCINT1)PB1), IC11.7 (CLK), J1.5 (SCLK), J2.3, Q3.2 (S), R17.1
SCL: IC1.6 (SCL), IC4.1 (SCL), IC5.6 (SCL), IC6.25 ((SCL/INT0)PD0), IC7.23 (SCL), IC9.20 (SCL_M), IC9.24 (SCL_A), R8.1
SDA: IC1.5 (SDA), IC4.6 (SDA), IC5.7 (SDA), IC6.26 ((SDA/INT1)PD1), IC7.24 (SDA), IC9.19 (SDA_M), IC9.25 (SDA_A), R9.1
SI1000_RXD: IC8.2 (NO1), IC13.31 (P0.5/RX), J4.4
SI1000_TXD: IC8.4 (NO2), IC13.32 (P0.4/TX), J4.3
UART_SELECT: IC6.4 ((XCK0/AIN0)PE2), IC8.1 (IN1), IC8.5 (IN2), R11.2
USBVCC: C7.1, C8.1, C52.1, F1.2, IC2.9 (RESET#), IC2.10 (VCC), IC17.1 (USB), LED2.A, LED3.A
USB_RXD: IC2.2 (RXD), IC6.3 ((TXD0/PDO)PE1), J2.1
USB_TXD: IC2.15 (TXD), IC6.2 ((RXD0/PCIN8/PDI)PE0), J2.4
VR_IF: IC13.20 (VR_IF)
V_BATT: C50.1, C51.1, C53.1, IC15.1 (VI), IC16.1 (EN), IC16.6 (VBAT), IC18.1 (VI), L9.1, Q9.3 (D), R35.2

Notes on the sheet:
Accelerometer I2C address: 001100xb Magnetometer I2C address: 011110xb x = hardware address select LSB b = read/write
LSM303DLM supply current = 360 µA
DS1338 supply current = 200 µA max.
ITG-3200 supply current = 6.5 mA.
Maximum current draw for AT45DB011D = 25 mA
VCC
!ENABLE
TXD
RXD
GROUND
Micro-SD card socket
Amphenol 101-00660-68-6
FT230XQ-R
General-purpose Rocket/Aircraft/Vehicle Telemetry Payload
Luke Weston, 2013
http://github.com/lukeweston/SSRPGenericTelemetryModule
Released under the CERN Open Hardware License:
http://ohwr.org/cernohl
8-CLCC
BMP085
IC5
