lukeweston/SSRPGenericTelemetryModule/SSRPGenericTelemetryModule.brd

## EAGLE design SSRPGenericTelemetryModule.brd (continued)

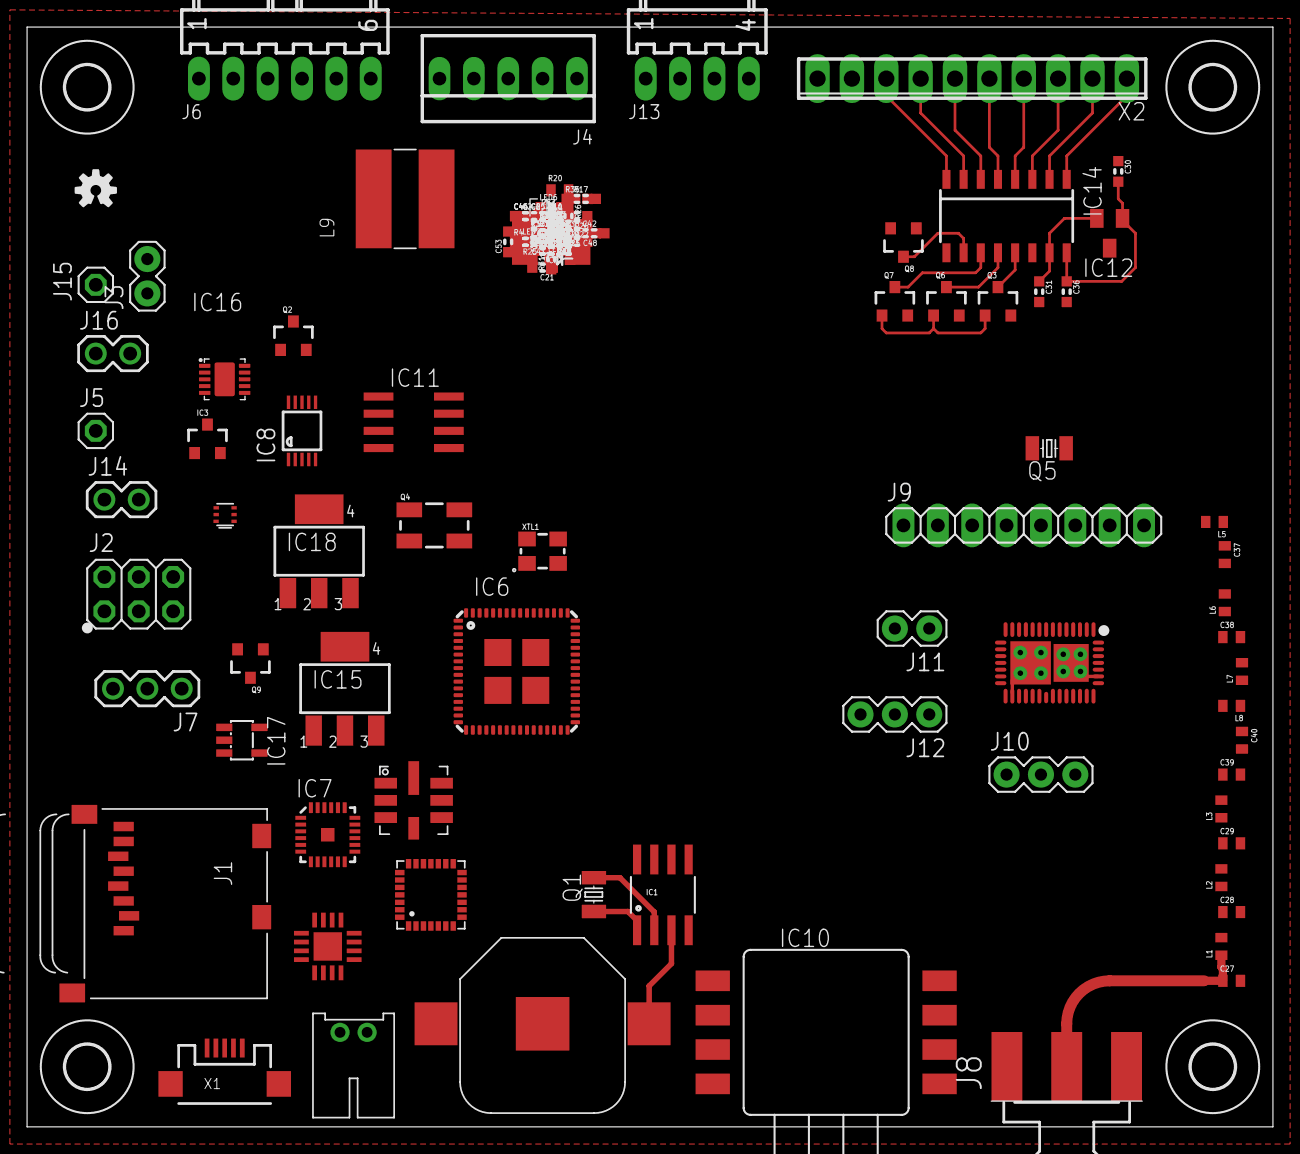
[picture p22: board SSRPGenericTelemetryModule.brd from above]

Board: 2 copper layers, 92.1 x 81.3 mm, 162 parts (0 on the bottom side), 118 nets.
