lukeweston/SSRPGenericTelemetryModule/HighRangeAccelerometer.brd

## EAGLE design HighRangeAccelerometer.brd (2013-02-17)

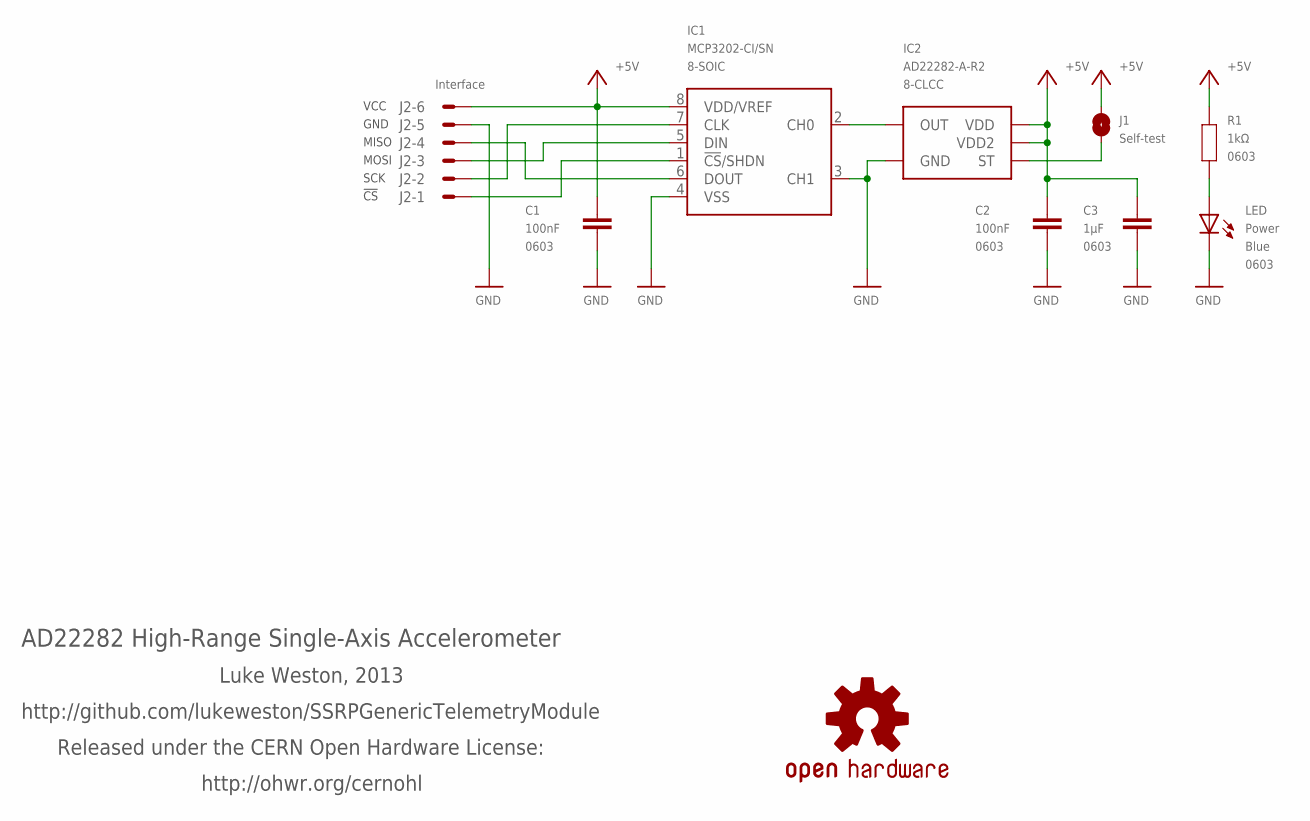
[picture p23: schematic HighRangeAccelerometer.sch]

Parts:
C1, C2: 100nF; 0603
C3: 1µF; 0603
IC1: MCP3202-CI/SN; SO-08
IC2: AD22282-A-R2; ADXL193
J1: Self-test; SJ
J2: Interface; 22-23-2061
LED: Power; LED-0603
R1: 1kΩ; 0603
SY: OSHW-LOGOS; OSHW-LOGO-S

Connections:
+5V: C1.2, C2.2, C3.2, IC1.8 (VDD/VREF), IC2.P$7 (VDD), IC2.P$8 (VDD2), J1.2, J2.6, R1.2
GND: C1.1, C2.1, C3.1, IC1.3 (CH1), IC1.4 (VSS), IC2.P$3 (GND), J2.5, LED.C
unnamed: IC1.2 (CH0), IC2.P$6 (OUT)
unnamed: LED.A, R1.1
unnamed: IC1.6 (DOUT), J2.4
unnamed: IC1.5 (DIN), J2.3
unnamed: IC1.7 (CLK), J2.2
unnamed: IC1.1 (!CS!/SHDN), J2.1
unnamed: IC2.P$4 (ST), J1.1

Notes on the sheet:
AD22282 High-Range Single-Axis Accelerometer
Luke Weston, 2013
http://github.com/lukeweston/SSRPGenericTelemetryModule
Released under the CERN Open Hardware License:
http://ohwr.org/cernohl
VCC
GND
MISO
MOSI
SCK
!CS

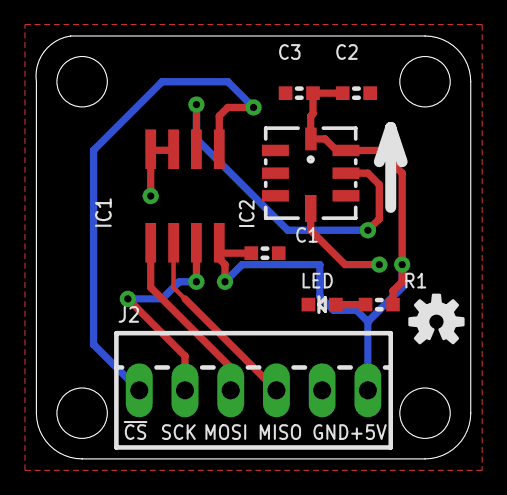
[picture p24: board HighRangeAccelerometer.brd from above]

Board: 2 copper layers, 24.2 x 23.5 mm, 10 parts (1 on the bottom side), 9 nets.
