lukeweston/SSRPGenericTelemetryModule/RFD900module.brd

## EAGLE design RFD900module.brd (2013-02-17)

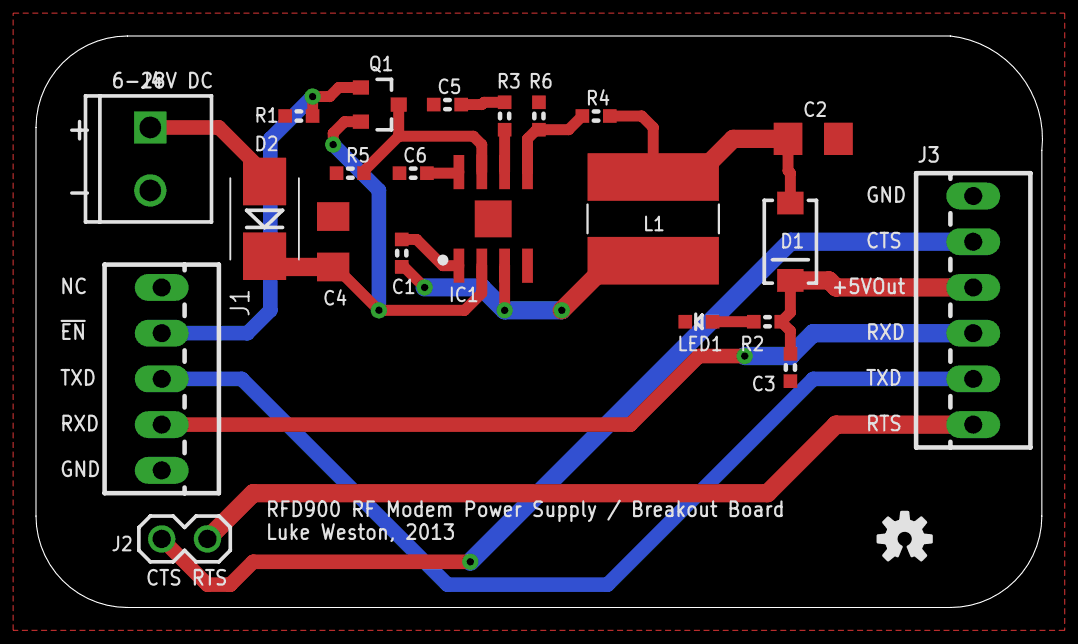
[picture p25: board RFD900module.brd from above]

Board: 2 copper layers, 55.9 x 31.8 mm, 23 parts (0 on the bottom side), 18 nets.

Parts:
C1: 10nF; 0603
C2: 22uF; C1206
C3: 1µF; 0603
C4: 10uF; C1206
C5: 2.2nF; 0603
C6: 100nF; 0603
D1: SK34A-LTP; SMA-DIODE
D2: SS16; SMA-SMB-DIODE
IC1: EUP3476; SO08T
J1: Interface; 22-23-2051
J2: Flow; 1X02
J3: Output; 22-23-2061
J4: Power In; SCREWTERMINAL-3.5MM-2
L1: 6.8 uH; CDRH
LED1: Power; LED-0603
Q1: DMP2035U-7; SOT23-3
R1, R5: 10kΩ; 0603
R2: 1kΩ; 0603
R3: 15kΩ; 0603
R4: 53.6kΩ 1%; 0603
R6: 10kΩ 1%; 0603
SY: OSHW-LOGOS; OSHW-LOGO-S

Connections:
!ENABLE: J1.2, Q1.1, R1.1
+5V: C3.2, D1.C, J3.4, R2.1
CTS: J2.2, J3.5
GND: C2.2, C3.1, C4.2, C5.1, C6.1, IC1.4, IC1.9, J1.5, J3.6, J4.2, LED1.C, R1.2, R5.2, R6.2
unnamed: D2.A, J4.1
unnamed: IC1.7, Q1.3, R5.1
unnamed: LED1.A, R2.2
unnamed: C2.1, D1.A, L1.2, R4.2
unnamed: C1.1, IC1.3, L1.1
unnamed: C1.2, IC1.1
unnamed: C5.2, R3.2
unnamed: IC1.6, R3.1
unnamed: C6.2, IC1.8
unnamed: IC1.5, R4.1, R6.1
RTS: J2.1, J3.1
RXD: J1.4, J3.3
TXD: J1.3, J3.2
VIN: C4.1, D2.C, IC1.2, Q1.2
