lukeweston/SSRPGenericTelemetryModule/HMTRPBreakoutModule.brd

## EAGLE design HMTRPBreakoutModule.brd (2013-02-17)

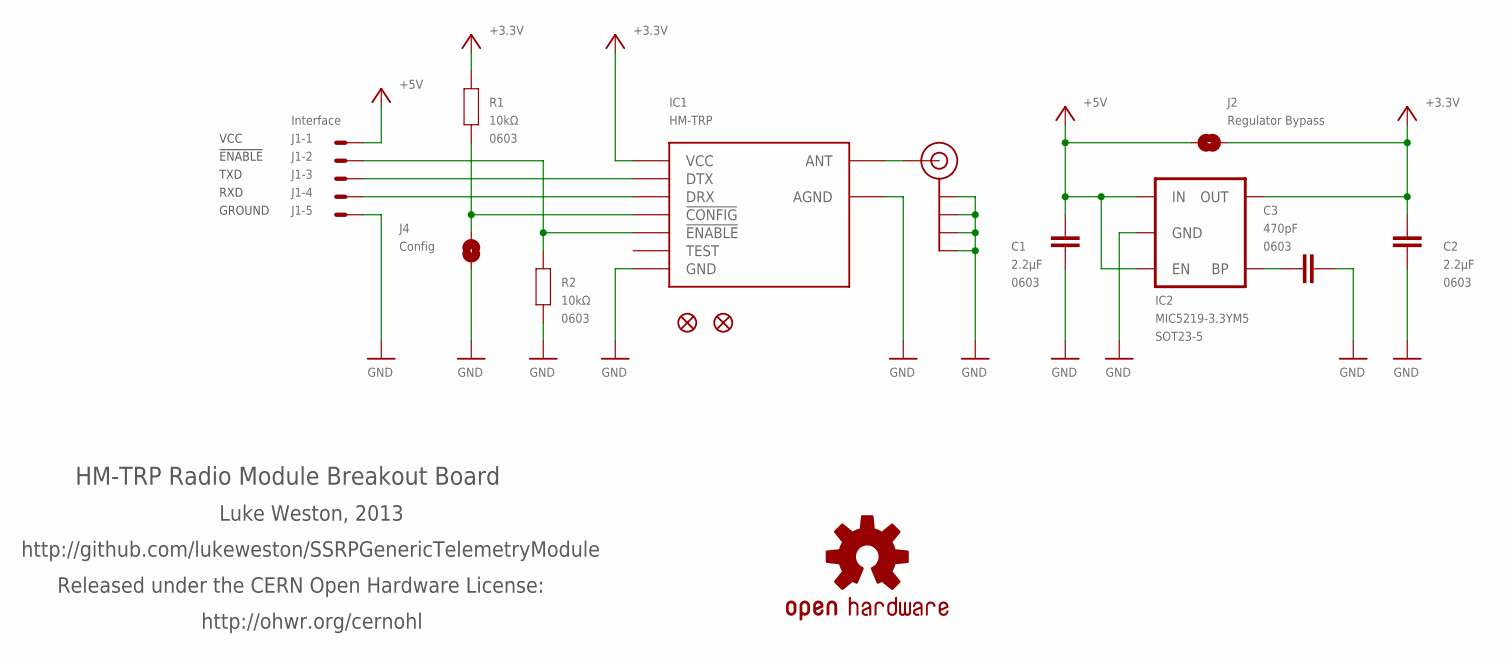
[picture p26: schematic HMTRPBreakoutModule.sch]

Parts:
C1, C2: 2.2µF; 0603
C3: 470pF; 0603
IC1: HM-TRP; HM-TRP-SMD
IC2: MIC5219-3.3YM5; SOT23-5
J1: Interface; 22-23-2051
J2: Regulator Bypass; SJ
J3: Antenna; SMA-EDGE
J4: Config; SJ
JP1, JP2: FIDUCIAL1X2; FIDUCIAL-1X2
R1, R2: 10kΩ; 0603
SY: OSHW-LOGOS; OSHW-LOGO-S

Connections:
+3V3: C2.1, IC1.VCC, IC2.5 (OUT), J2.2, R1.1
+5V: C1.1, IC2.1 (IN), IC2.3 (EN), J1.1, J2.1
GND: C1.2, C2.2, C3.1, IC1.AGND, IC1.GND, IC2.2 (GND), J1.5, J3.GND@0 (GND), J3.GND@1 (GND), J3.GND@2 (GND), J3.GND@3 (GND), J4.1, R2.2
unnamed: IC1.!ENABLE, J1.2, R2.1
unnamed: IC1.DTX, J1.3
unnamed: IC1.ANT, J3.SIG (SIGNAL)
unnamed: IC1.DRX, J1.4
unnamed: C3.2, IC2.4 (BP)
unnamed: IC1.!CONFIG, J4.2, R1.2

Notes on the sheet:
HM-TRP Radio Module Breakout Board
Luke Weston, 2013
http://github.com/lukeweston/SSRPGenericTelemetryModule
Released under the CERN Open Hardware License:
http://ohwr.org/cernohl
VCC
!ENABLE
TXD
RXD
GROUND

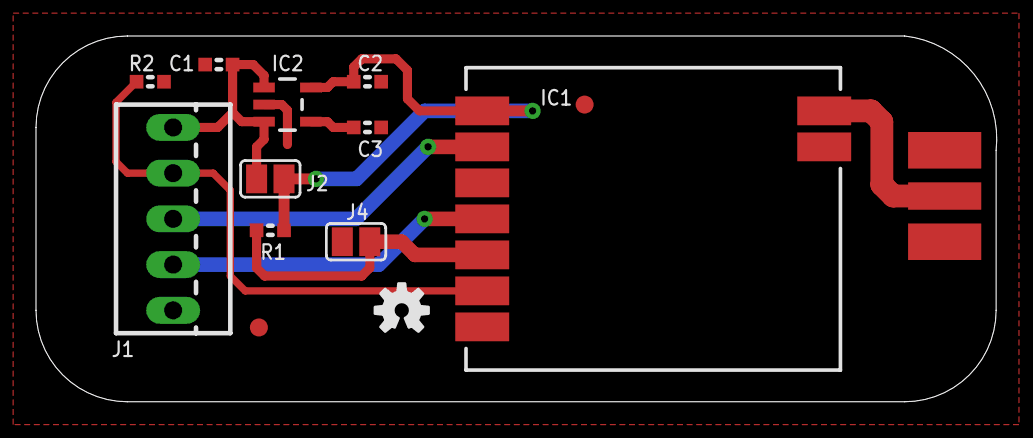
[picture p27: board HMTRPBreakoutModule.brd from above]

Board: 2 copper layers, 53.4 x 20.3 mm, 14 parts (0 on the bottom side), 9 nets.
